lynchaj/NS32016-BC/NS32016-BC-FRONT.jpg

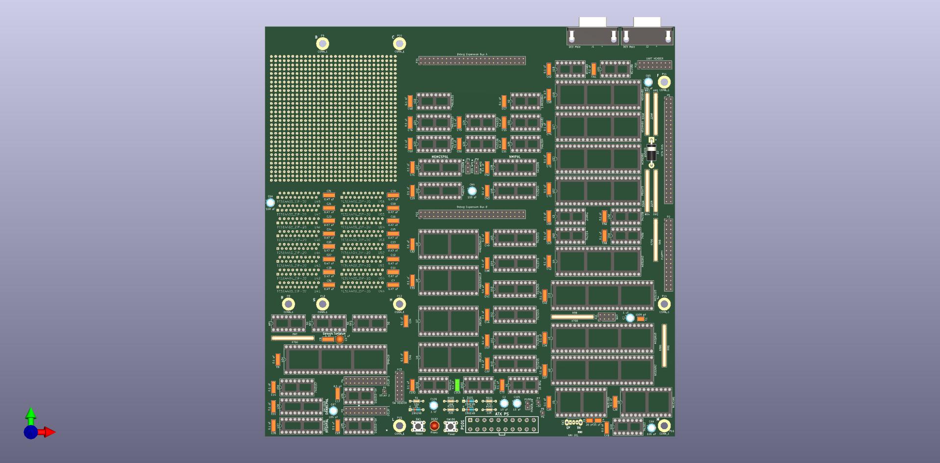
NS32016-BC-FRONT.jpg
