lynchaj/NS32016-BC/NS32016-BC-BACK.jpg

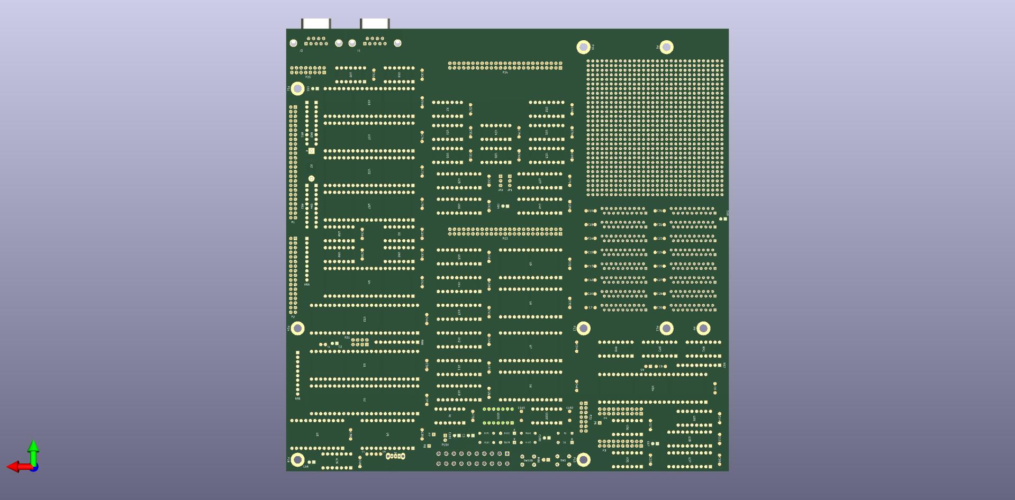
NS32016-BC-BACK.jpg
