lynchaj/NS32016-BC/(list of files, drawings)

Other design files:
NS32016-BC-1.dsn
NS32016-BC.dsn
