lynchaj/NS32016-BC/CPU.kicad_sch

## KiCad design CPU.kicad_sch (2024-06-16)

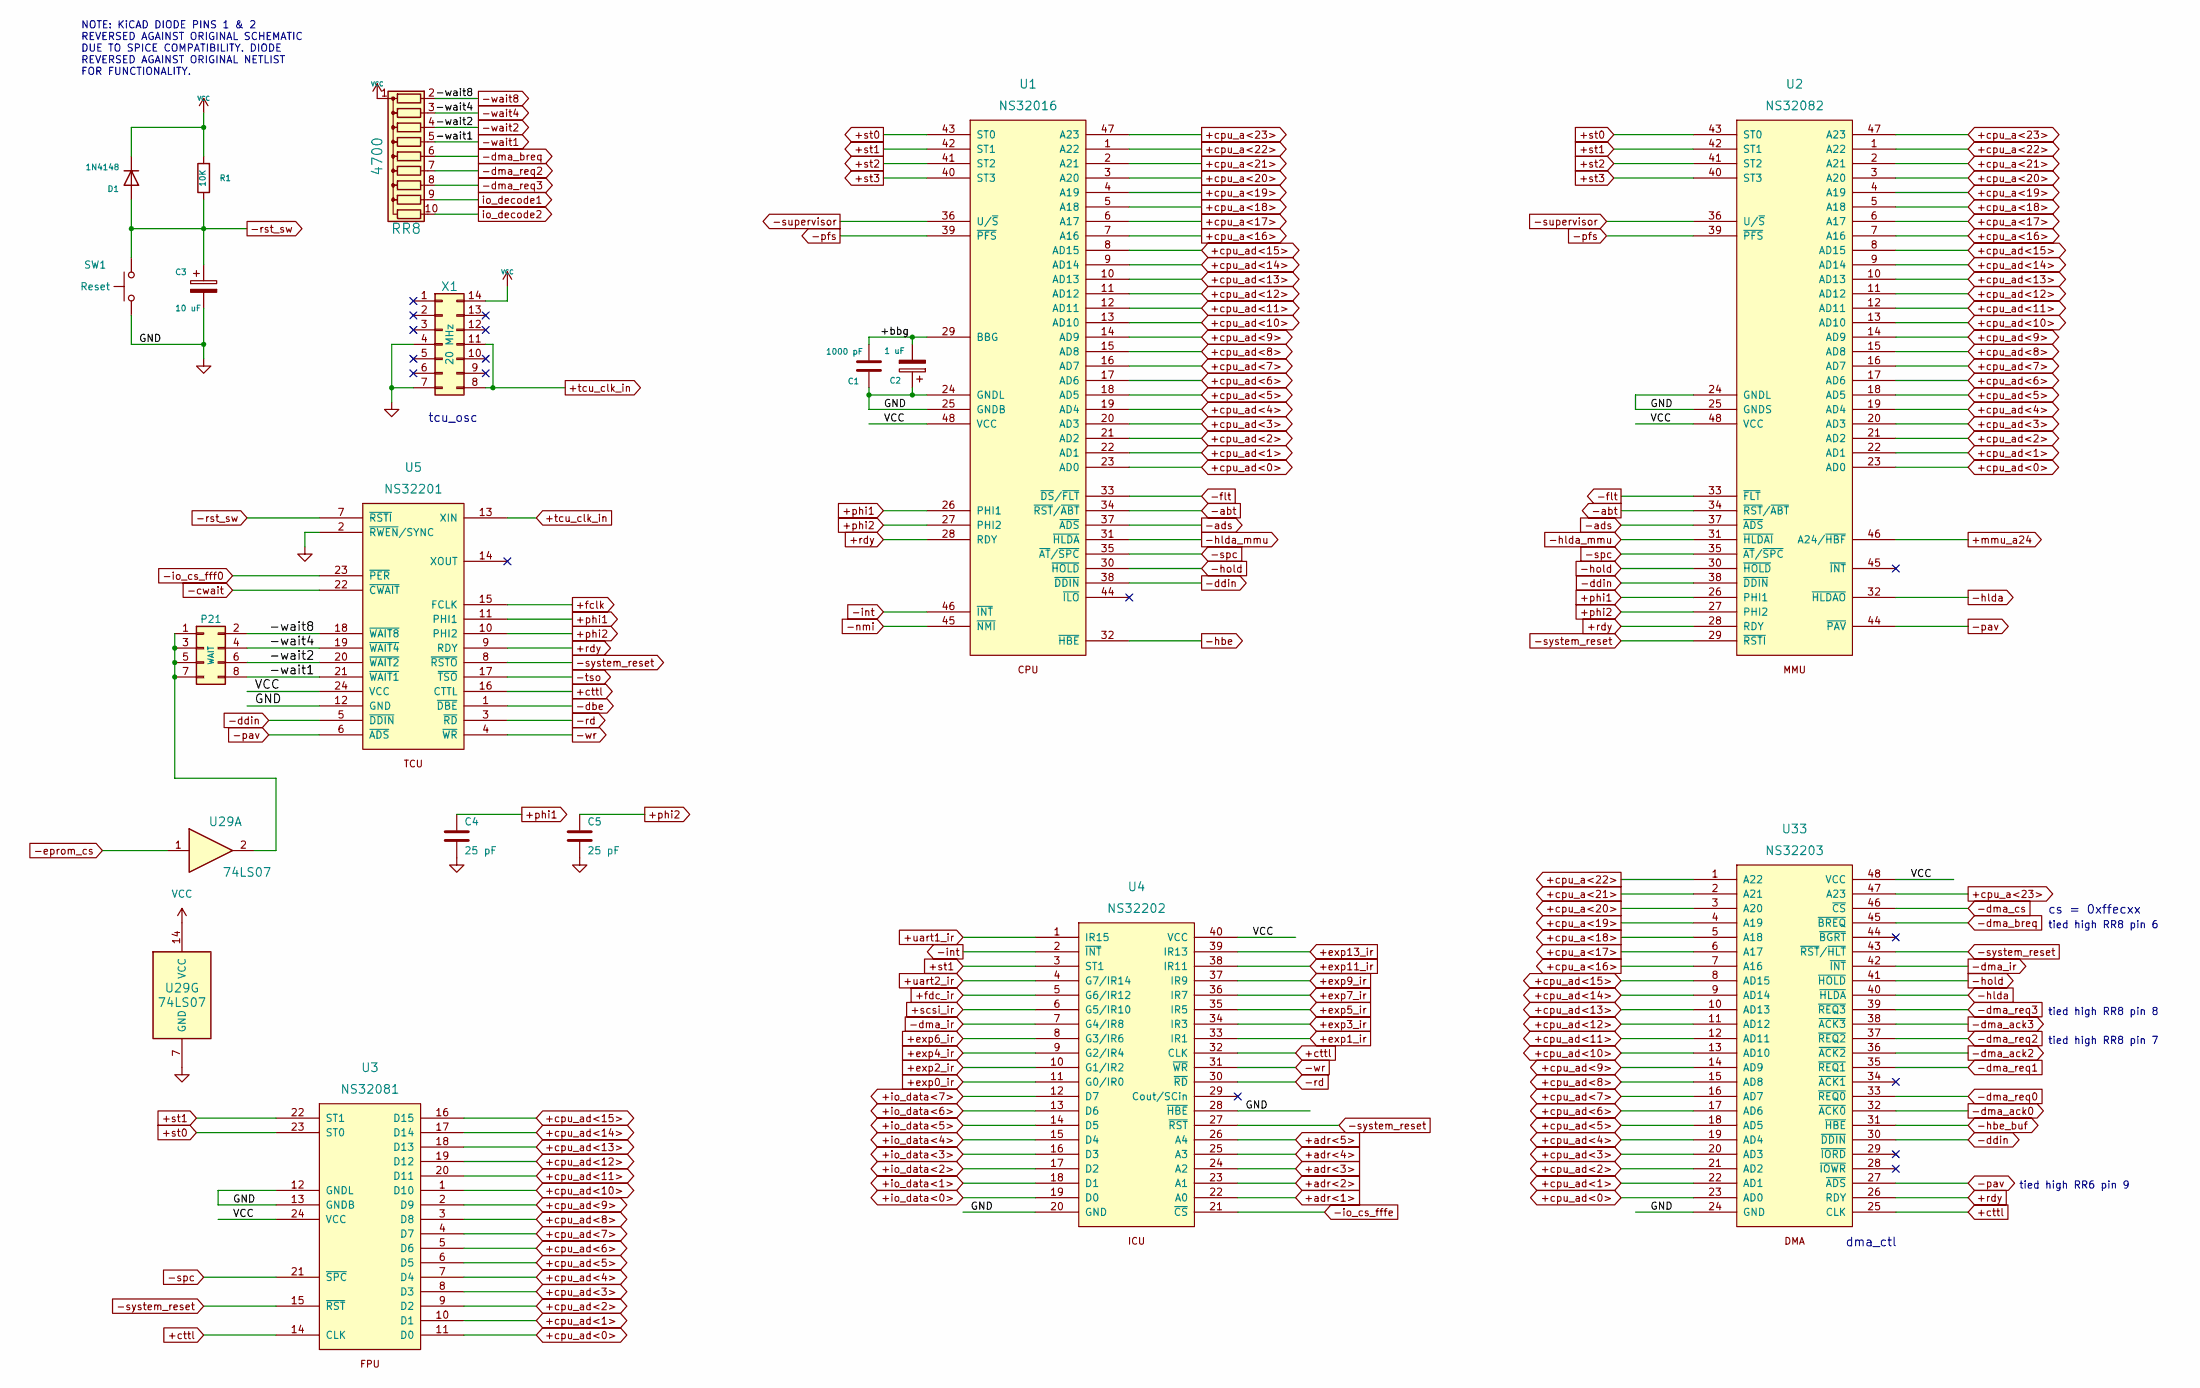
[picture p21: schematic CPU.kicad_sch]

Parts:
C1: 1000 pF; C_Rect_L4.0mm_W2.5mm_P2.50mm
C2: 1 uF; CP_Radial_D5.0mm_P2.50mm
C3: 10 uF; CP_Radial_D5.0mm_P2.50mm
C4, C5: 25 pF; C_Rect_L4.0mm_W2.5mm_P2.50mm
D1: 1N4148; D_DO-35_SOD27_P7.62mm_Horizontal
P21: WAIT; PinHeader_2x04_P2.54mm_Vertical
R1: 10K; R_Axial_DIN0204_L3.6mm_D1.6mm_P7.62mm_Horizontal
RR8: 4700; R_Array_SIP10
SW1: Reset; SW_PUSH_6mm
U1: NS32016; DIP-48_W15.24mm_Socket
U2: NS32082; DIP-48_W15.24mm_Socket
U3: NS32081; DIP-24_W15.24mm_Socket
U4: NS32202; DIP-40_W15.24mm_Socket
U5: NS32201; DIP-24_W15.24mm_Socket
U29: 74LS07; DIP-14_W7.62mm_Socket
U33: NS32203; DIP-48_W15.24mm_Socket
X1: 20 MHz; DIP-14_W7.62mm_Socket

Connections:
+adr<1>: U4.22 (A0)
+adr<2>: U4.23 (A1)
+adr<3>: U4.24 (A2)
+adr<4>: U4.25 (A3)
+adr<5>: U4.26 (A4)
+bbg: C1.1, C2.2, U1.29 (BBG)
+cpu_a<16>: U1.7 (A16), U2.7 (A16), U33.7 (A16)
+cpu_a<17>: U1.6 (A17), U2.6 (A17), U33.6 (A17)
+cpu_a<18>: U1.5 (A18), U2.5 (A18), U33.5 (A18)
+cpu_a<19>: U1.4 (A19), U2.4 (A19), U33.4 (A19)
+cpu_a<20>: U1.3 (A20), U2.3 (A20), U33.3 (A20)
+cpu_a<21>: U1.2 (A21), U2.2 (A21), U33.2 (A21)
+cpu_a<22>: U1.1 (A22), U2.1 (A22), U33.1 (A22)
+cpu_a<23>: U1.47 (A23), U2.47 (A23), U33.47 (A23)
+cpu_ad<0>: U1.23 (AD0), U2.23 (AD0), U3.11 (D0), U33.23 (AD0)
+cpu_ad<1>: U1.22 (AD1), U2.22 (AD1), U3.10 (D1), U33.22 (AD1)
+cpu_ad<2>: U1.21 (AD2), U2.21 (AD2), U3.9 (D2), U33.21 (AD2)
+cpu_ad<3>: U1.20 (AD3), U2.20 (AD3), U3.8 (D3), U33.20 (AD3)
+cpu_ad<4>: U1.19 (AD4), U2.19 (AD4), U3.7 (D4), U33.19 (AD4)
+cpu_ad<5>: U1.18 (AD5), U2.18 (AD5), U3.6 (D5), U33.18 (AD5)
+cpu_ad<6>: U1.17 (AD6), U2.17 (AD6), U3.5 (D6), U33.17 (AD6)
+cpu_ad<7>: U1.16 (AD7), U2.16 (AD7), U3.4 (D7), U33.16 (AD7)
+cpu_ad<8>: U1.15 (AD8), U2.15 (AD8), U3.3 (D8), U33.15 (AD8)
+cpu_ad<9>: U1.14 (AD9), U2.14 (AD9), U3.2 (D9), U33.14 (AD9)
+cpu_ad<10>: U1.13 (AD10), U2.13 (AD10), U3.1 (D10), U33.13 (AD10)
+cpu_ad<11>: U1.12 (AD11), U2.12 (AD11), U3.20 (D11), U33.12 (AD11)
+cpu_ad<12>: U1.11 (AD12), U2.11 (AD12), U3.19 (D12), U33.11 (AD12)
+cpu_ad<13>: U1.10 (AD13), U2.10 (AD13), U3.18 (D13), U33.10 (AD13)
+cpu_ad<14>: U1.9 (AD14), U2.9 (AD14), U3.17 (D14), U33.9 (AD14)
+cpu_ad<15>: U1.8 (AD15), U2.8 (AD15), U3.16 (D15), U33.8 (AD15)
+cttl: U3.14 (CLK), U4.32 (CLK), U5.16 (CTTL), U33.25 (CLK)
+exp0_ir: U4.11 (G0/IR0)
+exp1_ir: U4.33 (IR1)
+exp2_ir: U4.10 (G1/IR2)
+exp3_ir: U4.34 (IR3)
+exp4_ir: U4.9 (G2/IR4)
+exp5_ir: U4.35 (IR5)
+exp6_ir: U4.8 (G3/IR6)
+exp7_ir: U4.36 (IR7)
+exp9_ir: U4.37 (IR9)
+exp11_ir: U4.38 (IR11)
+exp13_ir: U4.39 (IR13)
+fclk: U5.15 (FCLK)
+fdc_ir: U4.5 (G6/IR12)
+io_data<0>: U4.19 (D0)
+io_data<1>: U4.18 (D1)
+io_data<2>: U4.17 (D2)
+io_data<3>: U4.16 (D3)
+io_data<4>: U4.15 (D4)
+io_data<5>: U4.14 (D5)
+io_data<6>: U4.13 (D6)
+io_data<7>: U4.12 (D7)
+mmu_a24: U2.46 (A24/~HBF)
+phi1: C4.1, U1.26 (PHI1), U2.26 (PHI1), U5.11 (PHI1)
+phi2: C5.1, U1.27 (PHI2), U2.27 (PHI2), U5.10 (PHI2)
+rdy: U1.28 (RDY), U2.28 (RDY), U5.9 (RDY), U33.26 (RDY)
+scsi_ir: U4.6 (G5/IR10)
+st0: U1.43 (ST0), U2.43 (ST0), U3.23 (ST0)
+st1: U1.42 (ST1), U2.42 (ST1), U3.22 (ST1), U4.3 (ST1)
+st2: U1.41 (ST2), U2.41 (ST2)
+st3: U1.40 (ST3), U2.40 (ST3)
+tcu_clk_in: U5.13 (XIN), X1.8, X1.11
+uart1_ir: U4.1 (IR15)
+uart2_ir: U4.4 (G7/IR14)
-abt: U1.34 (~RST/~ABT), U2.34 (~RST/~ABT)
-ads: U1.37 (~ADS), U2.37 (~ADS)
-cwait: U5.22 (~CWAIT)
-dbe: U5.1 (~DBE)
-ddin: U1.38 (~DDIN), U2.38 (~DDIN), U5.5 (~DDIN), U33.30 (~DDIN)
-dma_ack0: U33.32 (~ACK0)
-dma_ack2: U33.36 (~ACK2)
-dma_ack3: U33.38 (~ACK3)
-dma_breq: RR8.6 (R5), U33.45 (~BREQ)
-dma_cs: U33.46 (~CS)
-dma_ir: U4.7 (G4/IR8), U33.42 (~INT)
-dma_req0: U33.33 (~REQ0)
-dma_req1: U33.35 (~REQ1)
-dma_req2: RR8.7 (R6), U33.37 (~REQ2)
-dma_req3: RR8.8 (R7), U33.39 (~REQ3)
-eprom_cs: U29.1
-flt: U1.33 (~DS/~FLT), U2.33 (~FLT)
-hbe: U1.32 (~HBE)
-hbe_buf: U33.31 (~HBE)
-hlda: U2.32 (~HLDAO), U33.40 (~HLDA)
-hlda_mmu: U1.31 (~HLDA), U2.31 (~HLDAI)
-hold: U1.30 (~HOLD), U2.30 (~HOLD), U33.41 (~HOLD)
-int: U1.46 (~INT), U4.2 (~INT)
-io_cs_fff0: U5.23 (~PER)
-io_cs_fffe: U4.21 (~CS)
-nmi: U1.45 (~NMI)
-pav: U2.44 (~PAV), U5.6 (~ADS), U33.27 (~ADS)
-pfs: U1.39 (~PFS), U2.39 (~PFS)
-rd: U4.30 (~RD), U5.3 (~RD)
-rst_sw: C3.1, D1.2 (A), R1.1, SW1.2, U5.7 (~RSTI)
-spc: U1.35 (~AT/~SPC), U2.35 (~AT/~SPC), U3.21 (~SPC)
-supervisor: U1.36 (U/~S), U2.36 (U/~S)
-system_reset: U2.29 (~RSTI), U3.15 (~RST), U4.27 (~RST), U5.8 (~RSTO), U33.43 (~RST/~HLT)
-tso: U5.17 (~TSO)
-wait1: P21.8, RR8.5 (R4), U5.21 (~WAIT1)
-wait2: P21.6, RR8.4 (R3), U5.20 (~WAIT2)
-wait4: P21.4, RR8.3 (R2), U5.19 (~WAIT4)
-wait8: P21.2, RR8.2 (R1), U5.18 (~WAIT8)
-wr: U4.31 (~WR), U5.4 (~WR)
GND: C1.2, C2.1, C3.2, C4.2, C5.2, SW1.1, U1.24 (GNDL), U1.25 (GNDB), U2.24 (GNDL), U2.25 (GNDS), U3.12 (GNDL), U3.13 (GNDB), U4.20 (GND), U4.28 (~HBE), U5.2 (~RWEN/SYNC), U5.12 (GND), U29.7 (GND), U33.24 (GND), X1.4, X1.7
unnamed: P21.1, P21.3, P21.5, P21.7, U29.2
VCC: D1.1 (K), R1.2, RR8.1 (common), U1.48 (VCC), U2.48 (VCC), U3.24 (VCC), U4.40 (VCC), U5.24 (VCC), U29.14 (VCC), U33.48 (VCC), X1.14
io_decode1: RR8.9 (R8)
io_decode2: RR8.10 (R9)

Notes on the sheet:
dma_ctl
cs = 0xffecxx
tied high RR8 pin 8
tied high RR6 pin 9
tcu_osc
tied high RR8 pin 6
NOTE: KiCAD DIODE PINS 1 & 2 REVERSED AGAINST ORIGINAL SCHEMATIC DUE TO SPICE COMPATIBILITY. DIODE REVERSED AGAINST ORIGINAL NETLIST FOR FUNCTIONALITY.
tied high RR8 pin 7
