lynchaj/NS32016-BC/DRAM.kicad_sch

## KiCad design DRAM.kicad_sch (2024-06-16)

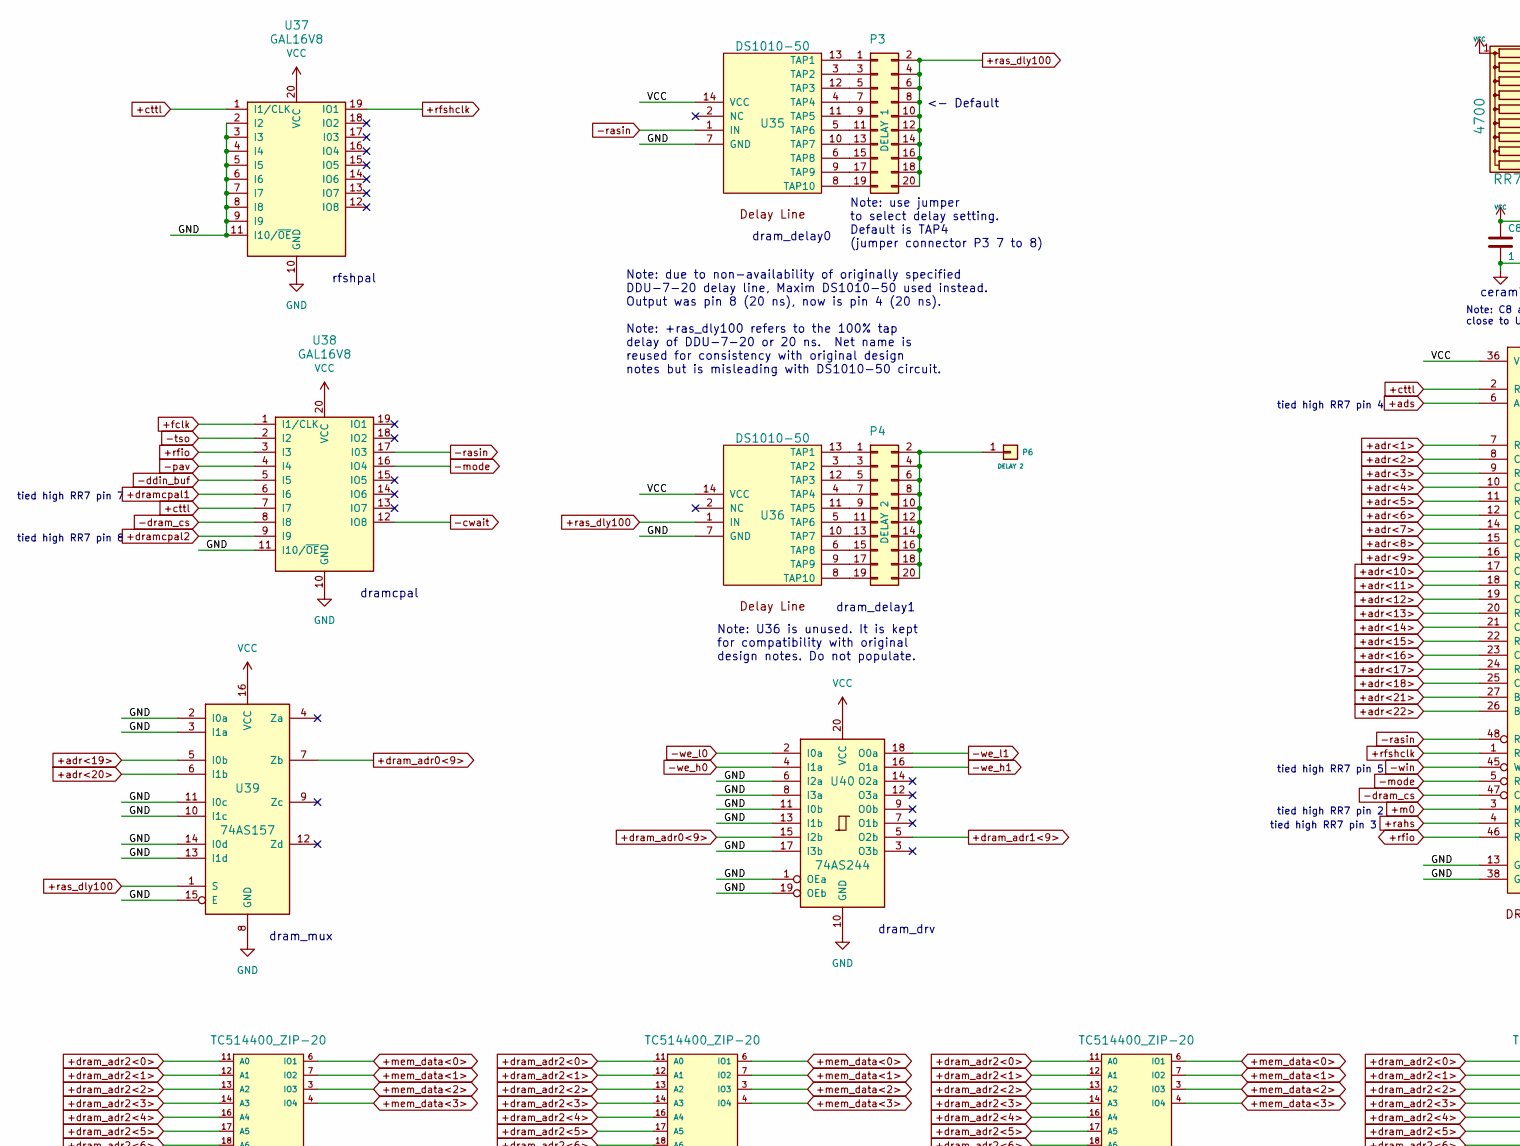
[picture p22: schematic DRAM.kicad_sch, part in row 1, column 1]

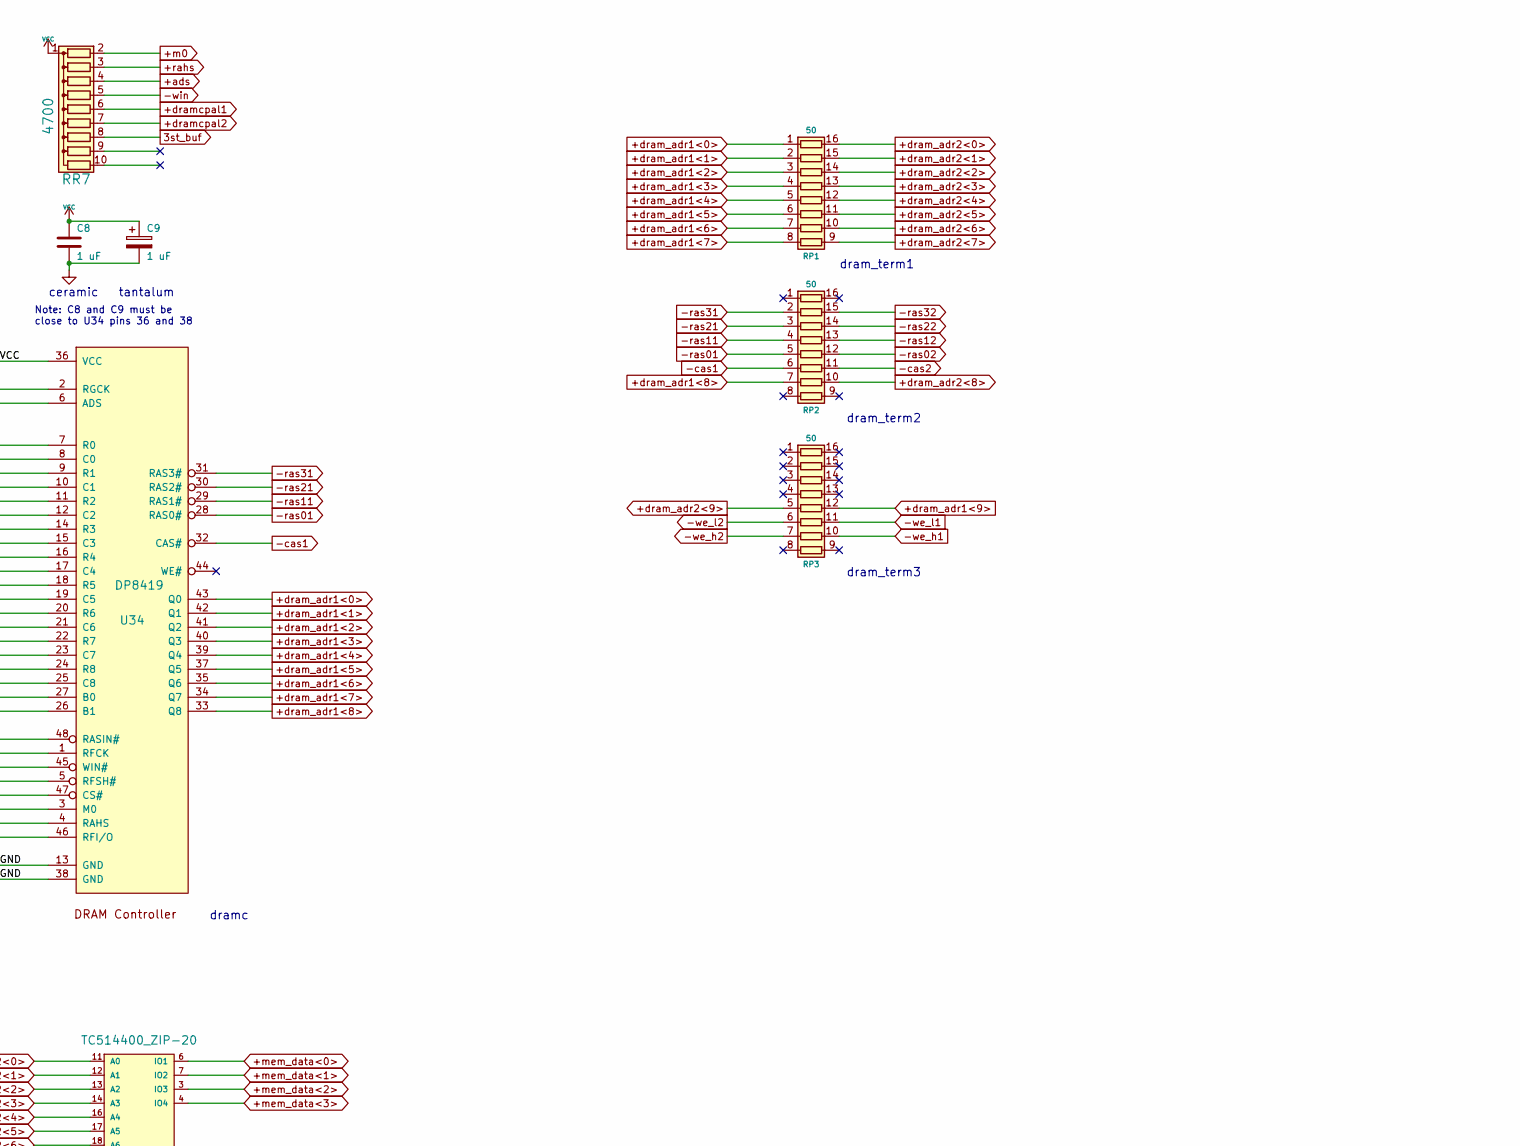
[picture p23: schematic DRAM.kicad_sch, part in row 1, column 2]

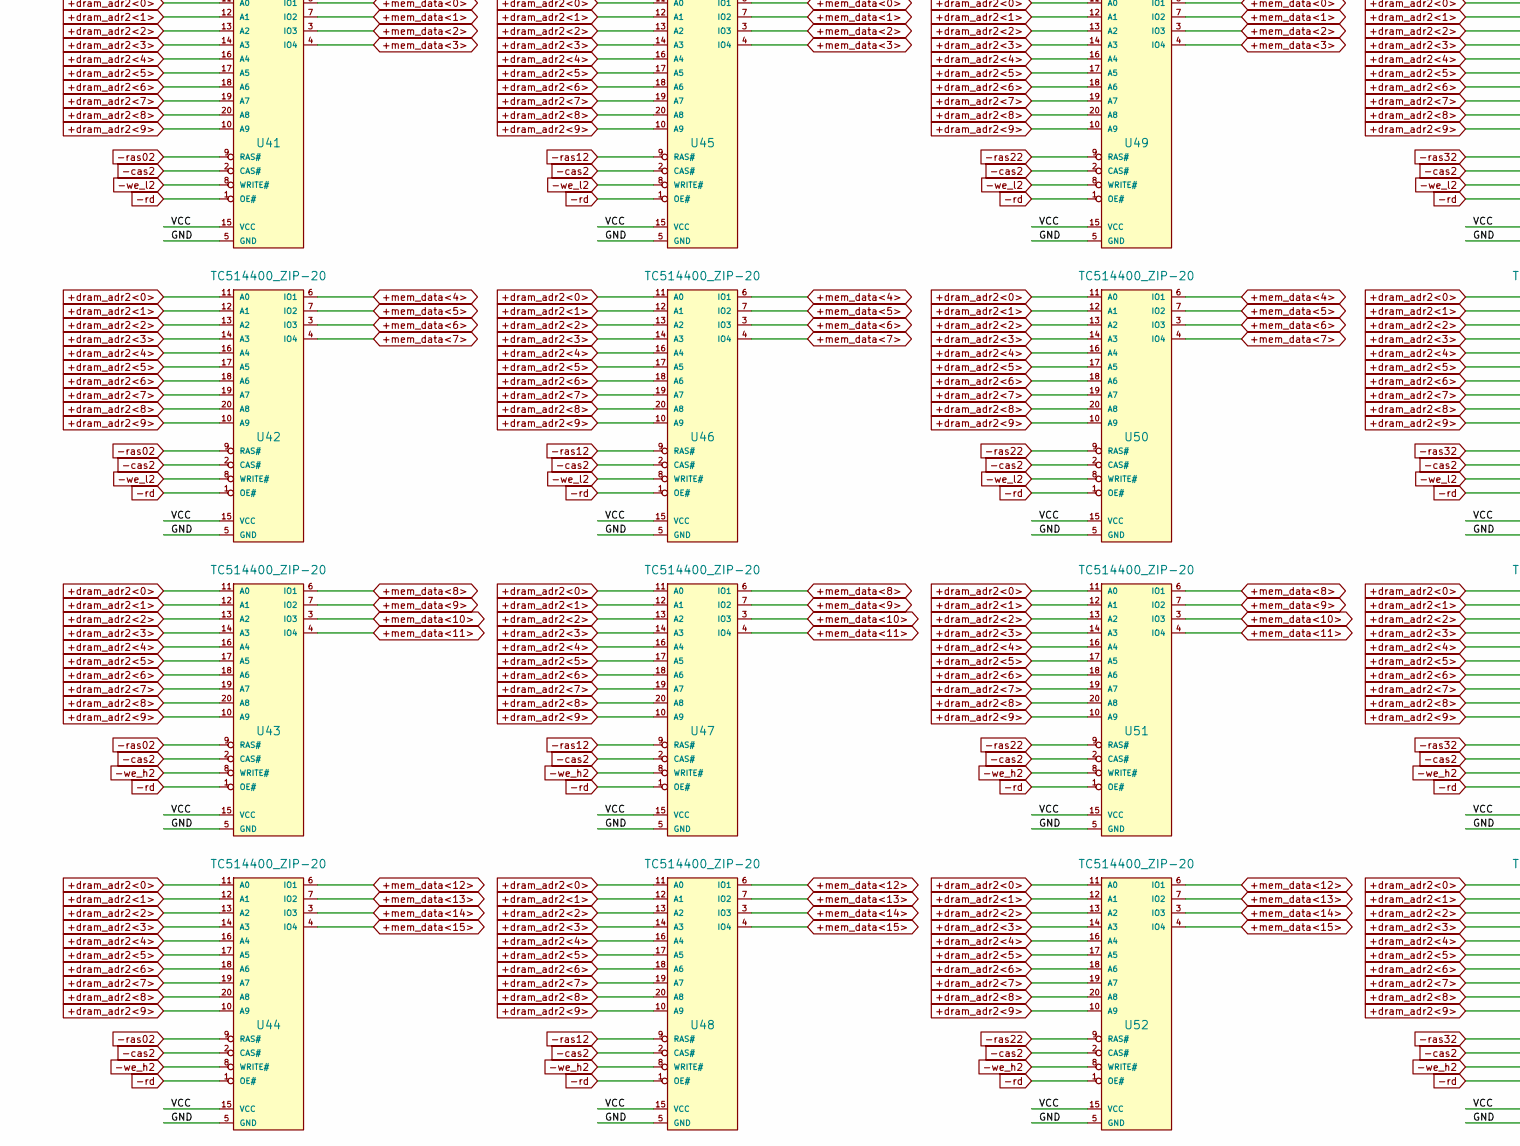
[picture p24: schematic DRAM.kicad_sch, part in row 2, column 1]

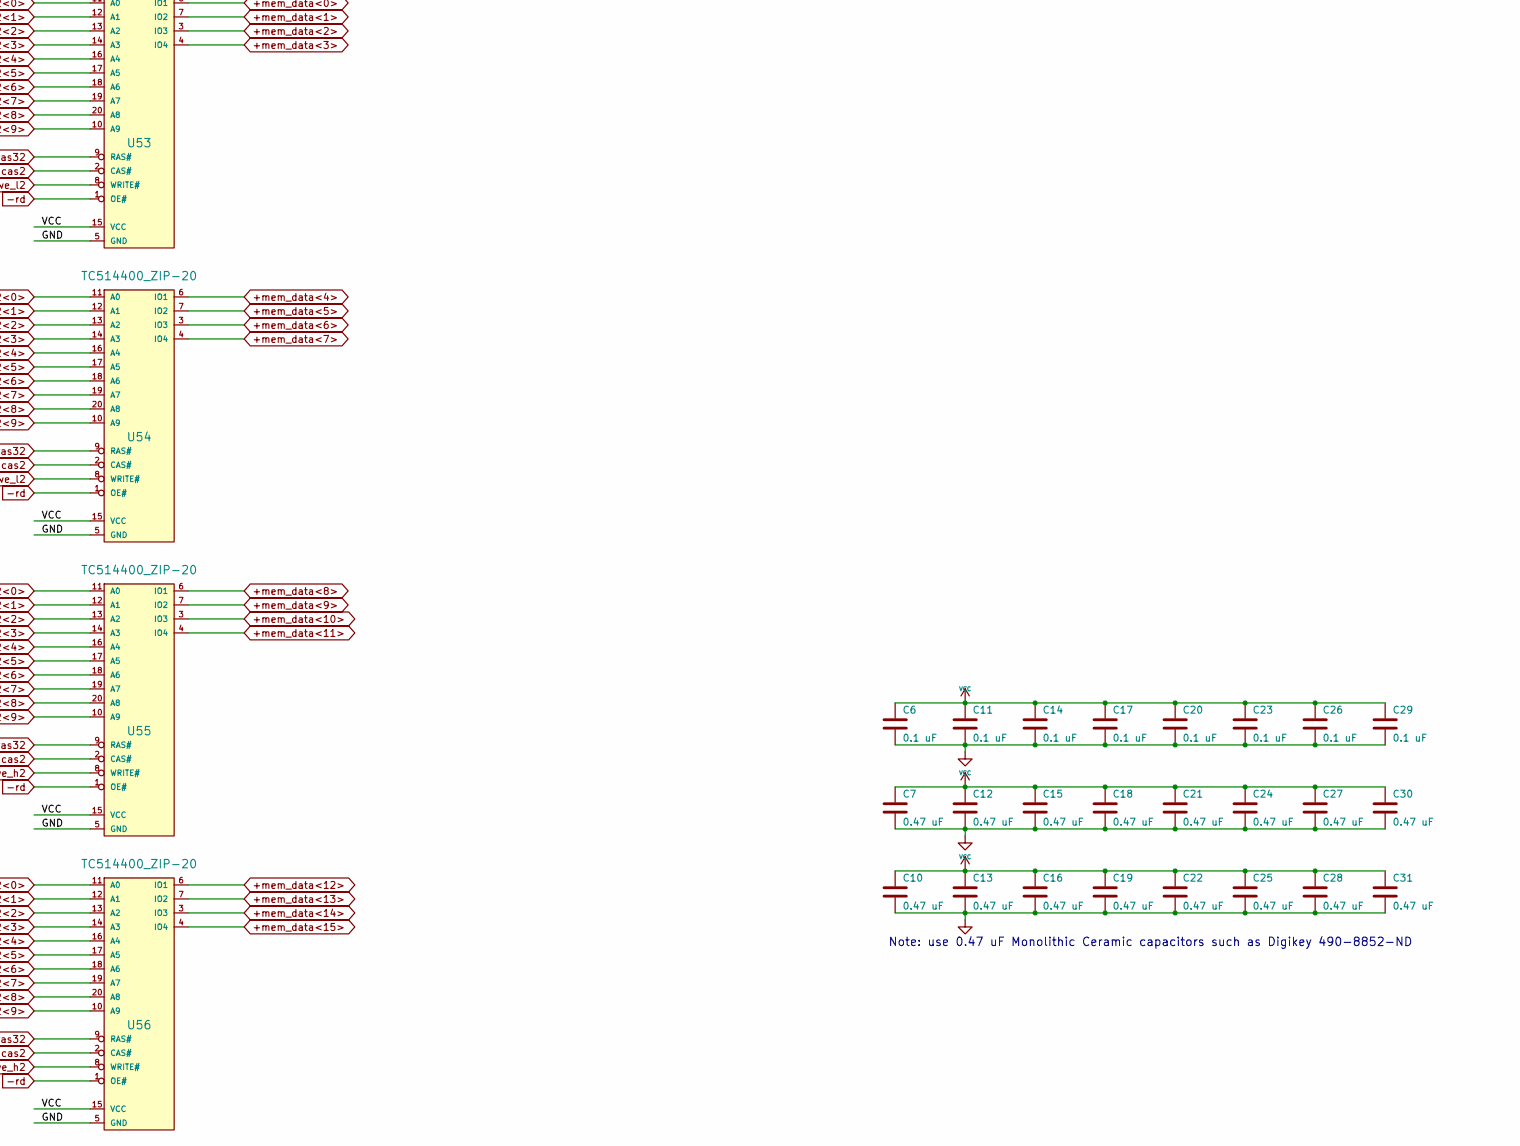
[picture p25: schematic DRAM.kicad_sch, part in row 2, column 2]

Parts:
C6, C11, C14, C17, C20, C23, C26, C29: 0.1 uF; C_Rect_L7.0mm_W2.5mm_P5.00mm
C7, C10, C12, C13, C15, C16, C18, C19, C21, C22, C24, C25, C27, C28, C30, C31: 0.47 uF; C_Rect_L7.0mm_W2.5mm_P5.00mm
C8: 1 uF; C_Rect_L7.0mm_W2.5mm_P5.00mm
C9: 1 uF; CP_Radial_Tantal_D5.0mm_P2.50mm
P3: DELAY 1; PinHeader_2x10_P2.54mm_Vertical
P4: DELAY 2; PinHeader_2x10_P2.54mm_Vertical
P6: DELAY 2; PinHeader_1x01_P2.54mm_Vertical
RP1, RP2, RP3: 50; DIP-16_W7.62mm_Socket
RR7: 4700; R_Array_SIP10
U34: DP8419; DIP-48_W15.24mm_Socket
U35, U36: DS1010-50; DIP-14_W7.62mm_Socket
U37, U38: GAL16V8; DIP-20_W7.62mm_Socket
U39: 74AS157; DIP-16_W7.62mm_Socket
U40: 74AS244; DIP-20_W7.62mm_Socket
U41, U42, U43, U44, U45, U46, U47, U48, U49, U50, U51, U52, U53, U54, U55, U56: TC514400_ZIP-20; TC14400_ZIP-20

Connections:
3st_buf: RR7.8 (R7)
+adr<1>: U34.7 (R0)
+adr<2>: U34.8 (C0)
+adr<3>: U34.9 (R1)
+adr<4>: U34.10 (C1)
+adr<5>: U34.11 (R2)
+adr<6>: U34.12 (C2)
+adr<7>: U34.14 (R3)
+adr<8>: U34.15 (C3)
+adr<9>: U34.16 (R4)
+adr<10>: U34.17 (C4)
+adr<11>: U34.18 (R5)
+adr<12>: U34.19 (C5)
+adr<13>: U34.20 (R6)
+adr<14>: U34.21 (C6)
+adr<15>: U34.22 (R7)
+adr<16>: U34.23 (C7)
+adr<17>: U34.24 (R8)
+adr<18>: U34.25 (C8)
+adr<19>: U39.5 (I0b)
+adr<20>: U39.6 (I1b)
+adr<21>: U34.27 (B0)
+adr<22>: U34.26 (B1)
+ads: RR7.4 (R3), U34.6 (ADS)
+cttl: U34.2 (RGCK), U37.1 (I1/CLK), U38.7 (I7)
+dram_adr0<9>: U39.7 (Zb), U40.15 (I2b)
+dram_adr1<0>: RP1.1 (R1.1), U34.43 (Q0)
+dram_adr1<1>: RP1.2 (R2.1), U34.42 (Q1)
+dram_adr1<2>: RP1.3 (R3.1), U34.41 (Q2)
+dram_adr1<3>: RP1.4 (R4.1), U34.40 (Q3)
+dram_adr1<4>: RP1.5 (R5.1), U34.39 (Q4)
+dram_adr1<5>: RP1.6 (R6.1), U34.37 (Q5)
+dram_adr1<6>: RP1.7 (R7.1), U34.35 (Q6)
+dram_adr1<7>: RP1.8 (R8.1), U34.34 (Q7)
+dram_adr1<8>: RP2.7 (R7.1), U34.33 (Q8)
+dram_adr1<9>: RP3.12 (R5.2), U40.5 (O2b)
+dram_adr2<0>: RP1.16 (R1.2), U41.11 (A0), U42.11 (A0), U43.11 (A0), U44.11 (A0), U45.11 (A0), U46.11 (A0), U47.11 (A0), U48.11 (A0), U49.11 (A0), U50.11 (A0), U51.11 (A0), U52.11 (A0), U53.11 (A0), U54.11 (A0), U55.11 (A0), U56.11 (A0)
+dram_adr2<1>: RP1.15 (R2.2), U41.12 (A1), U42.12 (A1), U43.12 (A1), U44.12 (A1), U45.12 (A1), U46.12 (A1), U47.12 (A1), U48.12 (A1), U49.12 (A1), U50.12 (A1), U51.12 (A1), U52.12 (A1), U53.12 (A1), U54.12 (A1), U55.12 (A1), U56.12 (A1)
+dram_adr2<2>: RP1.14 (R3.2), U41.13 (A2), U42.13 (A2), U43.13 (A2), U44.13 (A2), U45.13 (A2), U46.13 (A2), U47.13 (A2), U48.13 (A2), U49.13 (A2), U50.13 (A2), U51.13 (A2), U52.13 (A2), U53.13 (A2), U54.13 (A2), U55.13 (A2), U56.13 (A2)
+dram_adr2<3>: RP1.13 (R4.2), U41.14 (A3), U42.14 (A3), U43.14 (A3), U44.14 (A3), U45.14 (A3), U46.14 (A3), U47.14 (A3), U48.14 (A3), U49.14 (A3), U50.14 (A3), U51.14 (A3), U52.14 (A3), U53.14 (A3), U54.14 (A3), U55.14 (A3), U56.14 (A3)
+dram_adr2<4>: RP1.12 (R5.2), U41.16 (A4), U42.16 (A4), U43.16 (A4), U44.16 (A4), U45.16 (A4), U46.16 (A4), U47.16 (A4), U48.16 (A4), U49.16 (A4), U50.16 (A4), U51.16 (A4), U52.16 (A4), U53.16 (A4), U54.16 (A4), U55.16 (A4), U56.16 (A4)
+dram_adr2<5>: RP1.11 (R6.2), U41.17 (A5), U42.17 (A5), U43.17 (A5), U44.17 (A5), U45.17 (A5), U46.17 (A5), U47.17 (A5), U48.17 (A5), U49.17 (A5), U50.17 (A5), U51.17 (A5), U52.17 (A5), U53.17 (A5), U54.17 (A5), U55.17 (A5), U56.17 (A5)
+dram_adr2<6>: RP1.10 (R7.2), U41.18 (A6), U42.18 (A6), U43.18 (A6), U44.18 (A6), U45.18 (A6), U46.18 (A6), U47.18 (A6), U48.18 (A6), U49.18 (A6), U50.18 (A6), U51.18 (A6), U52.18 (A6), U53.18 (A6), U54.18 (A6), U55.18 (A6), U56.18 (A6)
+dram_adr2<7>: RP1.9 (R8.2), U41.19 (A7), U42.19 (A7), U43.19 (A7), U44.19 (A7), U45.19 (A7), U46.19 (A7), U47.19 (A7), U48.19 (A7), U49.19 (A7), U50.19 (A7), U51.19 (A7), U52.19 (A7), U53.19 (A7), U54.19 (A7), U55.19 (A7), U56.19 (A7)
+dram_adr2<8>: RP2.10 (R7.2), U41.20 (A8), U42.20 (A8), U43.20 (A8), U44.20 (A8), U45.20 (A8), U46.20 (A8), U47.20 (A8), U48.20 (A8), U49.20 (A8), U50.20 (A8), U51.20 (A8), U52.20 (A8), U53.20 (A8), U54.20 (A8), U55.20 (A8), U56.20 (A8)
+dram_adr2<9>: RP3.5 (R5.1), U41.10 (A9), U42.10 (A9), U43.10 (A9), U44.10 (A9), U45.10 (A9), U46.10 (A9), U47.10 (A9), U48.10 (A9), U49.10 (A9), U50.10 (A9), U51.10 (A9), U52.10 (A9), U53.10 (A9), U54.10 (A9), U55.10 (A9), U56.10 (A9)
+dramcpal1: RR7.6 (R5), U38.6 (I6)
+dramcpal2: RR7.7 (R6), U38.9 (I9)
+fclk: U38.1 (I1/CLK)
+m0: RR7.2 (R1), U34.3 (M0)
+mem_data<0>: U41.6 (IO1), U45.6 (IO1), U49.6 (IO1), U53.6 (IO1)
+mem_data<1>: U41.7 (IO2), U45.7 (IO2), U49.7 (IO2), U53.7 (IO2)
+mem_data<2>: U41.3 (IO3), U45.3 (IO3), U49.3 (IO3), U53.3 (IO3)
+mem_data<3>: U41.4 (IO4), U45.4 (IO4), U49.4 (IO4), U53.4 (IO4)
+mem_data<4>: U42.6 (IO1), U46.6 (IO1), U50.6 (IO1), U54.6 (IO1)
+mem_data<5>: U42.7 (IO2), U46.7 (IO2), U50.7 (IO2), U54.7 (IO2)
+mem_data<6>: U42.3 (IO3), U46.3 (IO3), U50.3 (IO3), U54.3 (IO3)
+mem_data<7>: U42.4 (IO4), U46.4 (IO4), U50.4 (IO4), U54.4 (IO4)
+mem_data<8>: U43.6 (IO1), U47.6 (IO1), U51.6 (IO1), U55.6 (IO1)
+mem_data<9>: U43.7 (IO2), U47.7 (IO2), U51.7 (IO2), U55.7 (IO2)
+mem_data<10>: U43.3 (IO3), U47.3 (IO3), U51.3 (IO3), U55.3 (IO3)
+mem_data<11>: U43.4 (IO4), U47.4 (IO4), U51.4 (IO4), U55.4 (IO4)
+mem_data<12>: U44.6 (IO1), U48.6 (IO1), U52.6 (IO1), U56.6 (IO1)
+mem_data<13>: U44.7 (IO2), U48.7 (IO2), U52.7 (IO2), U56.7 (IO2)
+mem_data<14>: U44.3 (IO3), U48.3 (IO3), U52.3 (IO3), U56.3 (IO3)
+mem_data<15>: U44.4 (IO4), U48.4 (IO4), U52.4 (IO4), U56.4 (IO4)
+rahs: RR7.3 (R2), U34.4 (RAHS)
+ras_dly100: P3.2, P3.4, P3.6, P3.8, P3.10, P3.12, P3.14, P3.16, P3.18, P3.20, U36.1 (IN), U39.1 (S)
+rfio: U34.46 (RFI/O), U38.3 (I3)
+rfshclk: U34.1 (RFCK), U37.19 (IO1)
-cas1: RP2.6 (R6.1), U34.32 (CAS#)
-cas2: RP2.11 (R6.2), U41.2 (CAS#), U42.2 (CAS#), U43.2 (CAS#), U44.2 (CAS#), U45.2 (CAS#), U46.2 (CAS#), U47.2 (CAS#), U48.2 (CAS#), U49.2 (CAS#), U50.2 (CAS#), U51.2 (CAS#), U52.2 (CAS#), U53.2 (CAS#), U54.2 (CAS#), U55.2 (CAS#), U56.2 (CAS#)
-cwait: U38.12 (IO8)
-ddin_buf: U38.5 (I5)
-dram_cs: U34.47 (CS#), U38.8 (I8)
-mode: U34.5 (RFSH#), U38.16 (IO4)
-pav: U38.4 (I4)
-ras01: RP2.5 (R5.1), U34.28 (RAS0#)
-ras02: RP2.12 (R5.2), U41.9 (RAS#), U42.9 (RAS#), U43.9 (RAS#), U44.9 (RAS#)
-ras11: RP2.4 (R4.1), U34.29 (RAS1#)
-ras12: RP2.13 (R4.2), U45.9 (RAS#), U46.9 (RAS#), U47.9 (RAS#), U48.9 (RAS#)
-ras21: RP2.3 (R3.1), U34.30 (RAS2#)
-ras22: RP2.14 (R3.2), U49.9 (RAS#), U50.9 (RAS#), U51.9 (RAS#), U52.9 (RAS#)
-ras31: RP2.2 (R2.1), U34.31 (RAS3#)
-ras32: RP2.15 (R2.2), U53.9 (RAS#), U54.9 (RAS#), U55.9 (RAS#), U56.9 (RAS#)
-rasin: U34.48 (RASIN#), U35.1 (IN), U38.17 (I03)
-rd: U41.1 (OE#), U42.1 (OE#), U43.1 (OE#), U44.1 (OE#), U45.1 (OE#), U46.1 (OE#), U47.1 (OE#), U48.1 (OE#), U49.1 (OE#), U50.1 (OE#), U51.1 (OE#), U52.1 (OE#), U53.1 (OE#), U54.1 (OE#), U55.1 (OE#), U56.1 (OE#)
-tso: U38.2 (I2)
-we_h0: U40.4 (I1a)
-we_h1: RP3.10 (R7.2), U40.16 (O1a)
-we_h2: RP3.7 (R7.1), U43.8 (WRITE#), U44.8 (WRITE#), U47.8 (WRITE#), U48.8 (WRITE#), U51.8 (WRITE#), U52.8 (WRITE#), U55.8 (WRITE#), U56.8 (WRITE#)
-we_l0: U40.2 (I0a)
-we_l1: RP3.11 (R6.2), U40.18 (O0a)
-we_l2: RP3.6 (R6.1), U41.8 (WRITE#), U42.8 (WRITE#), U45.8 (WRITE#), U46.8 (WRITE#), U49.8 (WRITE#), U50.8 (WRITE#), U53.8 (WRITE#), U54.8 (WRITE#)
-win: RR7.5 (R4), U34.45 (WIN#)
GND: C6.2, C7.2, C8.2, C9.2, C10.2, C11.2, C12.2, C13.2, C14.2, C15.2, C16.2, C17.2, C18.2, C19.2, C20.2, C21.2, C22.2, C23.2, C24.2, C25.2, C26.2, C27.2, C28.2, C29.2, C30.2, C31.2, U34.13 (GND), U34.38 (GND), U35.7 (GND), U36.7 (GND), U37.2 (I2), U37.3 (I3), U37.4 (I4), U37.5 (I5), U37.6 (I6), U37.7 (I7), U37.8 (I8), U37.9 (I9), U37.10 (GND), U37.11 (I10/~OE), U38.10 (GND), U38.11 (I10/~OE), U39.2 (I0a), U39.3 (I1a), U39.8 (GND), U39.10 (I1c), U39.11 (I0c), U39.13 (I1d), U39.14 (I0d), U39.15 (E), U40.1 (OEa), U40.6 (I2a), U40.8 (I3a), U40.10 (GND), U40.11 (I0b), U40.13 (I1b), U40.17 (I3b), U40.19 (OEb), U41.5 (GND), U42.5 (GND), U43.5 (GND), U44.5 (GND), U45.5 (GND), U46.5 (GND), U47.5 (GND), U48.5 (GND), U49.5 (GND), U50.5 (GND), U51.5 (GND), U52.5 (GND), U53.5 (GND), U54.5 (GND), U55.5 (GND), U56.5 (GND)
unnamed: P3.1, U35.13 (TAP1)
unnamed: P3.3, U35.3 (TAP2)
unnamed: P3.5, U35.12 (TAP3)
unnamed: P3.7, U35.4 (TAP4)
unnamed: P3.9, U35.11 (TAP5)
unnamed: P3.11, U35.5 (TAP6)
unnamed: P3.13, U35.10 (TAP7)
unnamed: P3.15, U35.6 (TAP8)
unnamed: P3.17, U35.9 (TAP9)
unnamed: P3.19, U35.8 (TAP10)
unnamed: P4.1, U36.13 (TAP1)
unnamed: P4.3, U36.3 (TAP2)
unnamed: P4.5, U36.12 (TAP3)
unnamed: P4.7, U36.4 (TAP4)
unnamed: P4.9, U36.11 (TAP5)
unnamed: P4.2, P4.4, P4.6, P4.8, P4.10, P4.12, P4.14, P4.16, P4.18, P4.20, P6.1
unnamed: P4.11, U36.5 (TAP6)
unnamed: P4.13, U36.10 (TAP7)
unnamed: P4.15, U36.6 (TAP8)
unnamed: P4.17, U36.9 (TAP9)
unnamed: P4.19, U36.8 (TAP10)
VCC: C6.1, C7.1, C8.1, C9.1, C10.1, C11.1, C12.1, C13.1, C14.1, C15.1, C16.1, C17.1, C18.1, C19.1, C20.1, C21.1, C22.1, C23.1, C24.1, C25.1, C26.1, C27.1, C28.1, C29.1, C30.1, C31.1, RR7.1 (common), U34.36 (VCC), U35.14 (VCC), U36.14 (VCC), U37.20 (VCC), U38.20 (VCC), U39.16 (VCC), U40.20 (VCC), U41.15 (VCC), U42.15 (VCC), U43.15 (VCC), U44.15 (VCC), U45.15 (VCC), U46.15 (VCC), U47.15 (VCC), U48.15 (VCC), U49.15 (VCC), U50.15 (VCC), U51.15 (VCC), U52.15 (VCC), U53.15 (VCC), U54.15 (VCC), U55.15 (VCC), U56.15 (VCC)

Notes on the sheet:
Note: due to non-availability of originally specified DDU-7-20 delay line, Maxim DS1010-50 used instead. Output was pin 8 (20 ns), now is pin 4 (20 ns). Note: +ras_dly100 refers to the 100% tap delay of DDU-7-20 or 20 ns. Net name is reused for consistency with original design notes but is misleadi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
dram_mux
dram_term1
tantalum
tied high RR7 pin 5
dram_term2
tied high RR7 pin 3
Note: C8 and C9 must be close to U34 pins 36 and 38
dram_delay1
tied high RR7 pin 4
<- Default
tied high RR7 pin 8
ceramic
dramc
Note: use jumper to select delay setting. Default is TAP4 (jumper connector P3 7 to 8)
dramcpal
dram_term3
tied high RR7 pin 2
tied high RR7 pin 7
rfshpal
Note: U36 is unused. It is kept for compatibility with original design notes. Do not populate.
dram_delay0
Note: use 0.47 uF Monolithic Ceramic capacitors such as Digikey 490-8852-ND
dram_drv
