lynchaj/NS32016-BC/Decoders.kicad_sch

## KiCad design Decoders.kicad_sch (2024-06-16)

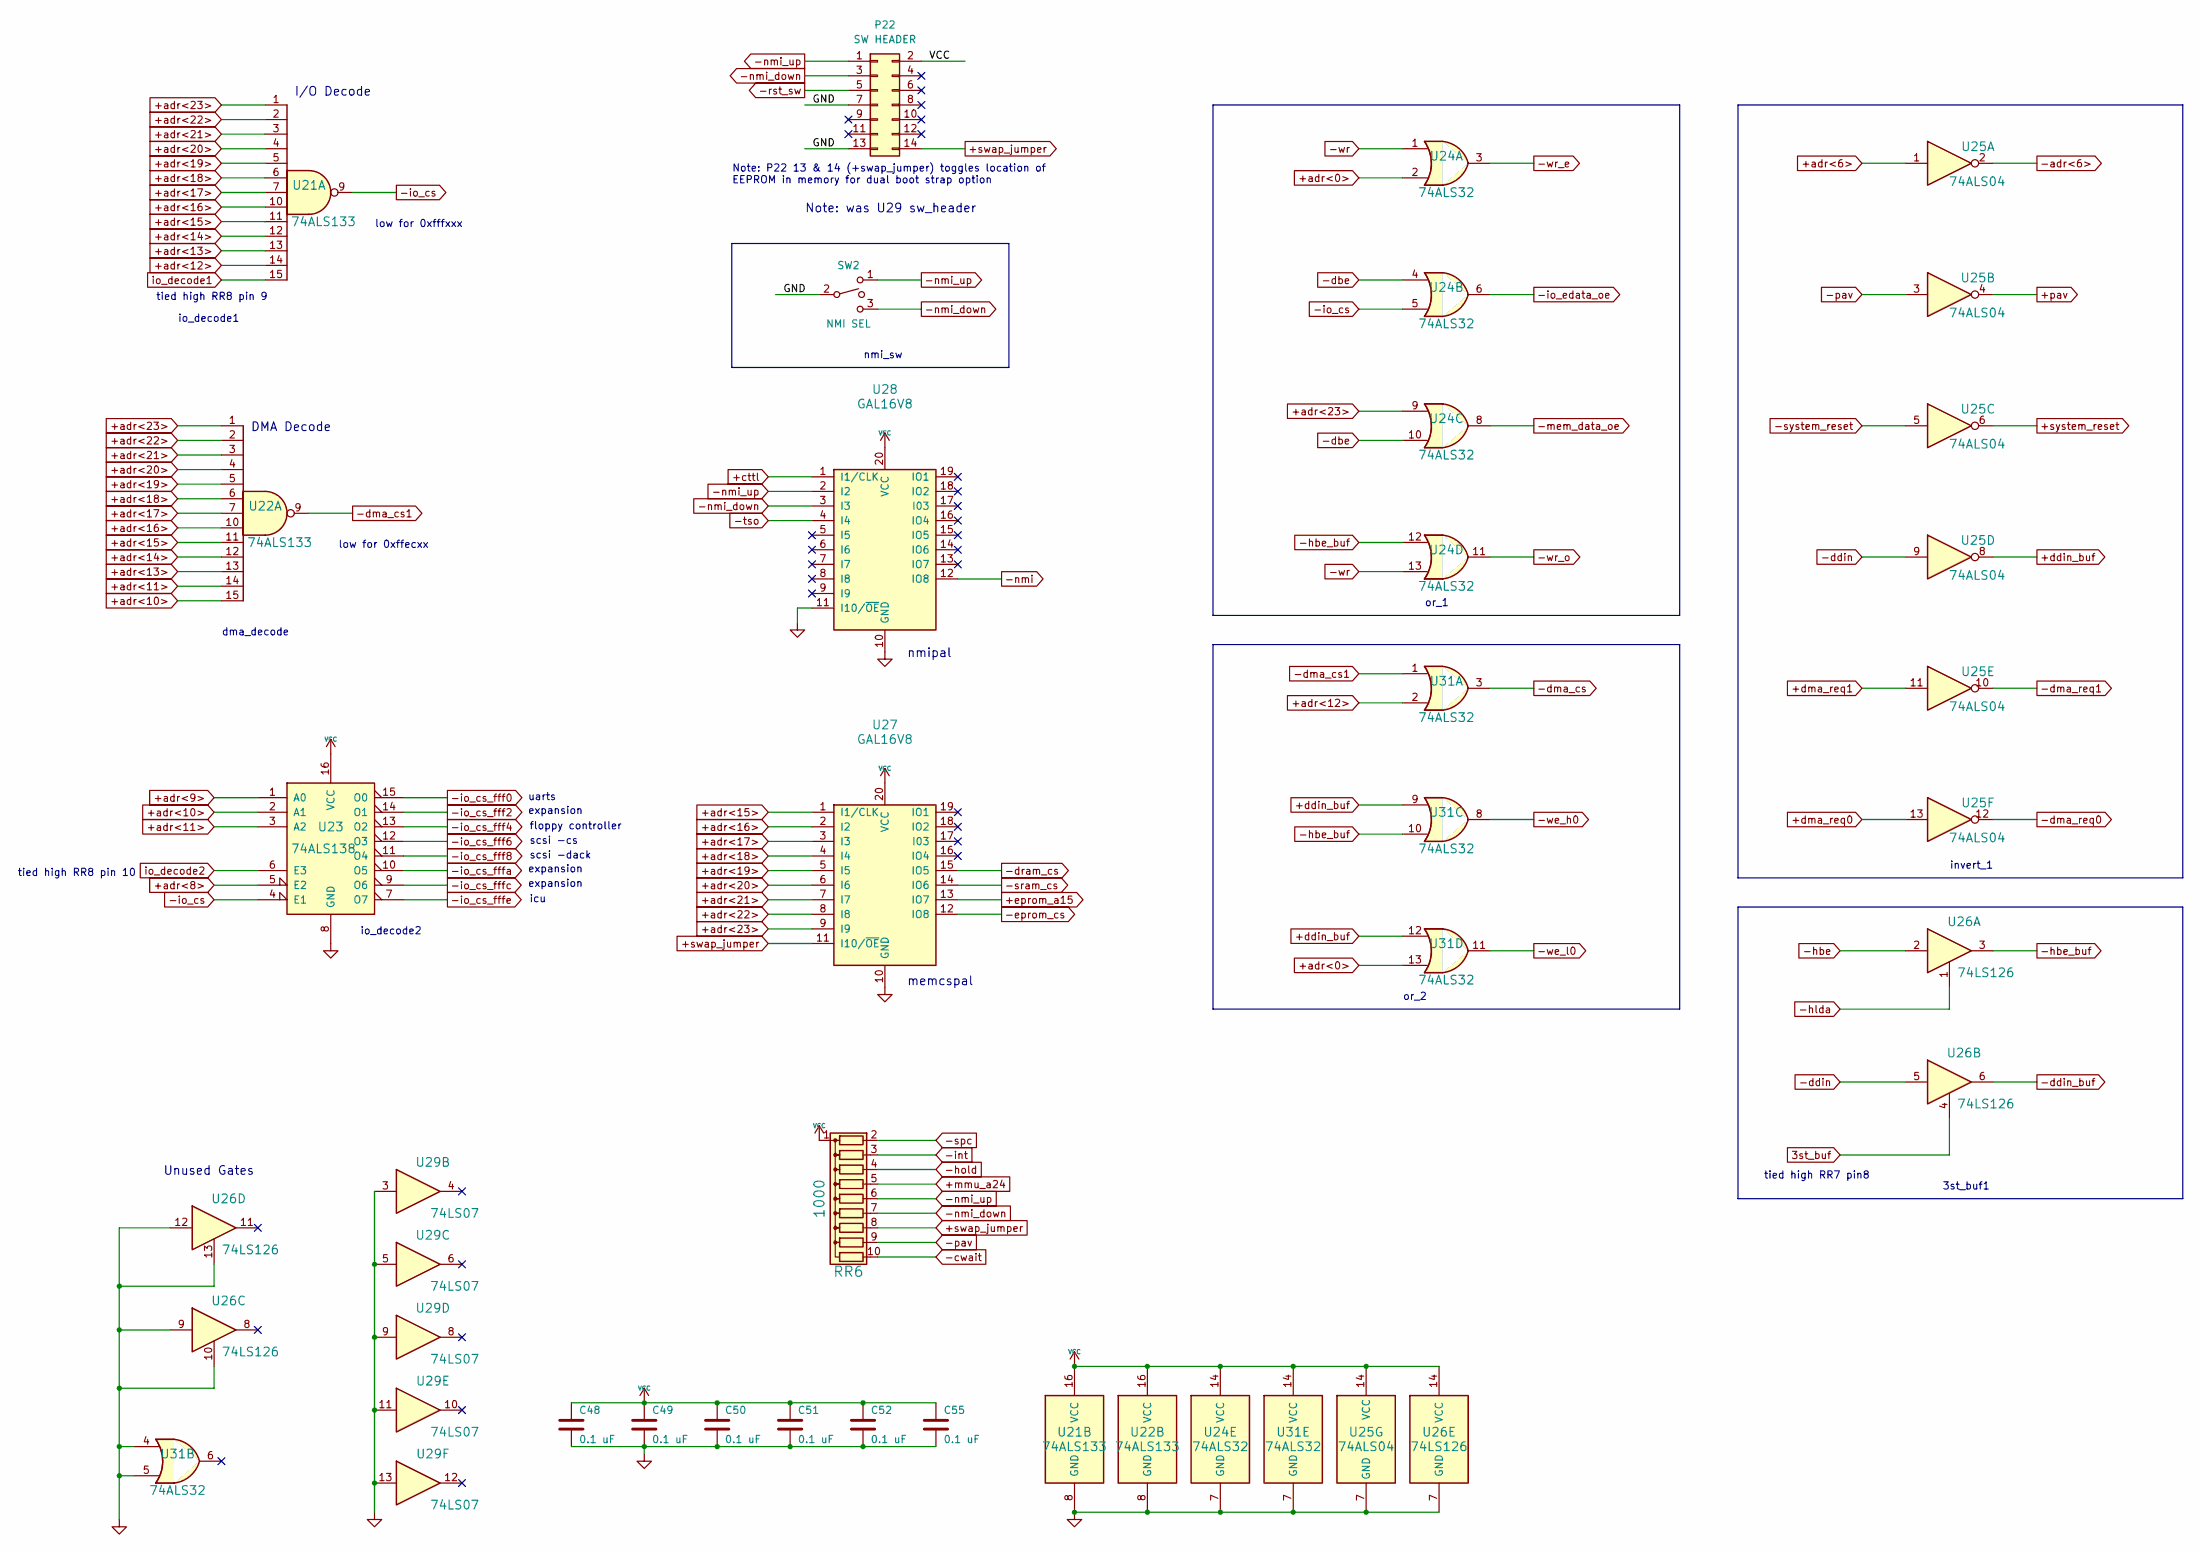
[picture p26: schematic Decoders.kicad_sch]

Parts:
C48, C49, C50, C51, C52, C55: 0.1 uF; C_Rect_L7.0mm_W2.5mm_P5.00mm
P22: SW HEADER; PinHeader_2x07_P2.54mm_Vertical
RR6: 1000; R_Array_SIP10
SW2: NMI SEL; SW_CuK_OS102011MA1QN1_SPDT_Angled
U21, U22: 74ALS133; DIP-16_W7.62mm_Socket
U23: 74ALS138; DIP-16_W7.62mm_Socket
U24, U31: 74ALS32; DIP-14_W7.62mm_Socket
U25: 74ALS04; DIP-14_W7.62mm_Socket
U26: 74LS126; DIP-14_W7.62mm_Socket
U27, U28: GAL16V8; DIP-20_W7.62mm_Socket
U29: 74LS07; DIP-14_W7.62mm_Socket

Connections:
3st_buf: U26.4
+adr<0>: U24.2, U31.13
+adr<6>: U25.1
+adr<8>: U23.5 (E2)
+adr<9>: U23.1 (A0)
+adr<10>: U22.15, U23.2 (A1)
+adr<11>: U22.14, U23.3 (A2)
+adr<12>: U21.14, U31.2
+adr<13>: U21.13, U22.13
+adr<14>: U21.12, U22.12
+adr<15>: U21.11, U22.11, U27.1 (I1/CLK)
+adr<16>: U21.10, U22.10, U27.2 (I2)
+adr<17>: U21.7, U22.7, U27.3 (I3)
+adr<18>: U21.6, U22.6, U27.4 (I4)
+adr<19>: U21.5, U22.5, U27.5 (I5)
+adr<20>: U21.4, U22.4, U27.6 (I6)
+adr<21>: U21.3, U22.3, U27.7 (I7)
+adr<22>: U21.2, U22.2, U27.8 (I8)
+adr<23>: U21.1, U22.1, U24.9, U27.9 (I9)
+cttl: U28.1 (I1/CLK)
+ddin_buf: U25.8, U31.9, U31.12
+dma_req0: U25.13
+dma_req1: U25.11
+eprom_a15: U27.13 (IO7)
+mmu_a24: RR6.5 (R4)
+pav: U25.4
+swap_jumper: P22.14, RR6.8 (R7), U27.11 (I10/~OE)
+system_reset: U25.6
-adr<6>: U25.2
-cwait: RR6.10 (R9)
-dbe: U24.4, U24.10
-ddin: U25.9, U26.5
-ddin_buf: U26.6
-dma_cs: U31.3
-dma_cs1: U22.9, U31.1
-dma_req0: U25.12
-dma_req1: U25.10
-dram_cs: U27.15 (IO5)
-eprom_cs: U27.12 (IO8)
-hbe: U26.2
-hbe_buf: U24.12, U26.3, U31.10
-hlda: U26.1
-hold: RR6.4 (R3)
-int: RR6.3 (R2)
-io_cs: U21.9, U23.4 (E1), U24.5
-io_cs_fff0: U23.15 (O0)
-io_cs_fff2: U23.14 (O1)
-io_cs_fff4: U23.13 (O2)
-io_cs_fff6: U23.12 (O3)
-io_cs_fff8: U23.11 (O4)
-io_cs_fffa: U23.10 (O5)
-io_cs_fffc: U23.9 (O6)
-io_cs_fffe: U23.7 (O7)
-io_edata_oe: U24.6
-mem_data_oe: U24.8
-nmi: U28.12 (IO8)
-nmi_down: P22.3, RR6.7 (R6), SW2.3, U28.3 (I3)
-nmi_up: P22.1, RR6.6 (R5), SW2.1, U28.2 (I2)
-pav: RR6.9 (R8), U25.3
-rst_sw: P22.5
-spc: RR6.2 (R1)
-sram_cs: U27.14 (IO6)
-system_reset: U25.5
-tso: U28.4 (I4)
-we_h0: U31.8
-we_l0: U31.11
-wr: U24.1, U24.13
-wr_e: U24.3
-wr_o: U24.11
GND: C48.2, C49.2, C50.2, C51.2, C52.2, C55.2, P22.7, P22.13, SW2.2, U21.8 (GND), U22.8 (GND), U23.8 (GND), U24.7 (GND), U25.7 (GND), U26.7 (GND), U26.9, U26.10, U26.12, U26.13, U27.10 (GND), U28.10 (GND), U28.11 (I10/~OE), U29.3, U29.5, U29.9, U29.11, U29.13, U31.4, U31.5, U31.7 (GND)
VCC: C48.1, C49.1, C50.1, C51.1, C52.1, C55.1, P22.2, RR6.1 (common), U21.16 (VCC), U22.16 (VCC), U23.16 (VCC), U24.14 (VCC), U25.14 (VCC), U26.14 (VCC), U27.20 (VCC), U28.20 (VCC), U31.14 (VCC)
io_decode1: U21.15
io_decode2: U23.6 (E3)

Notes on the sheet:
expansion
scsi -dack
low for 0xffecxx
Unused Gates
scsi -cs
tied high RR8 pin 10
nmipal
I/O Decode
DMA Decode
memcspal
tied high RR8 pin 9
icu
invert_1
low for 0xfffxxx
io_decode1
or_2
nmi_sw
io_decode2
3st_buf1
Note: was U29 sw_header
Note: P22 13 & 14 (+swap_jumper) toggles location of EEPROM in memory for dual boot strap option
tied high RR7 pin8
or_1
dma_decode
floppy controller
uarts
