lynchaj/NS32016-BC/IO.kicad_sch

## KiCad design IO.kicad_sch (2024-06-16)

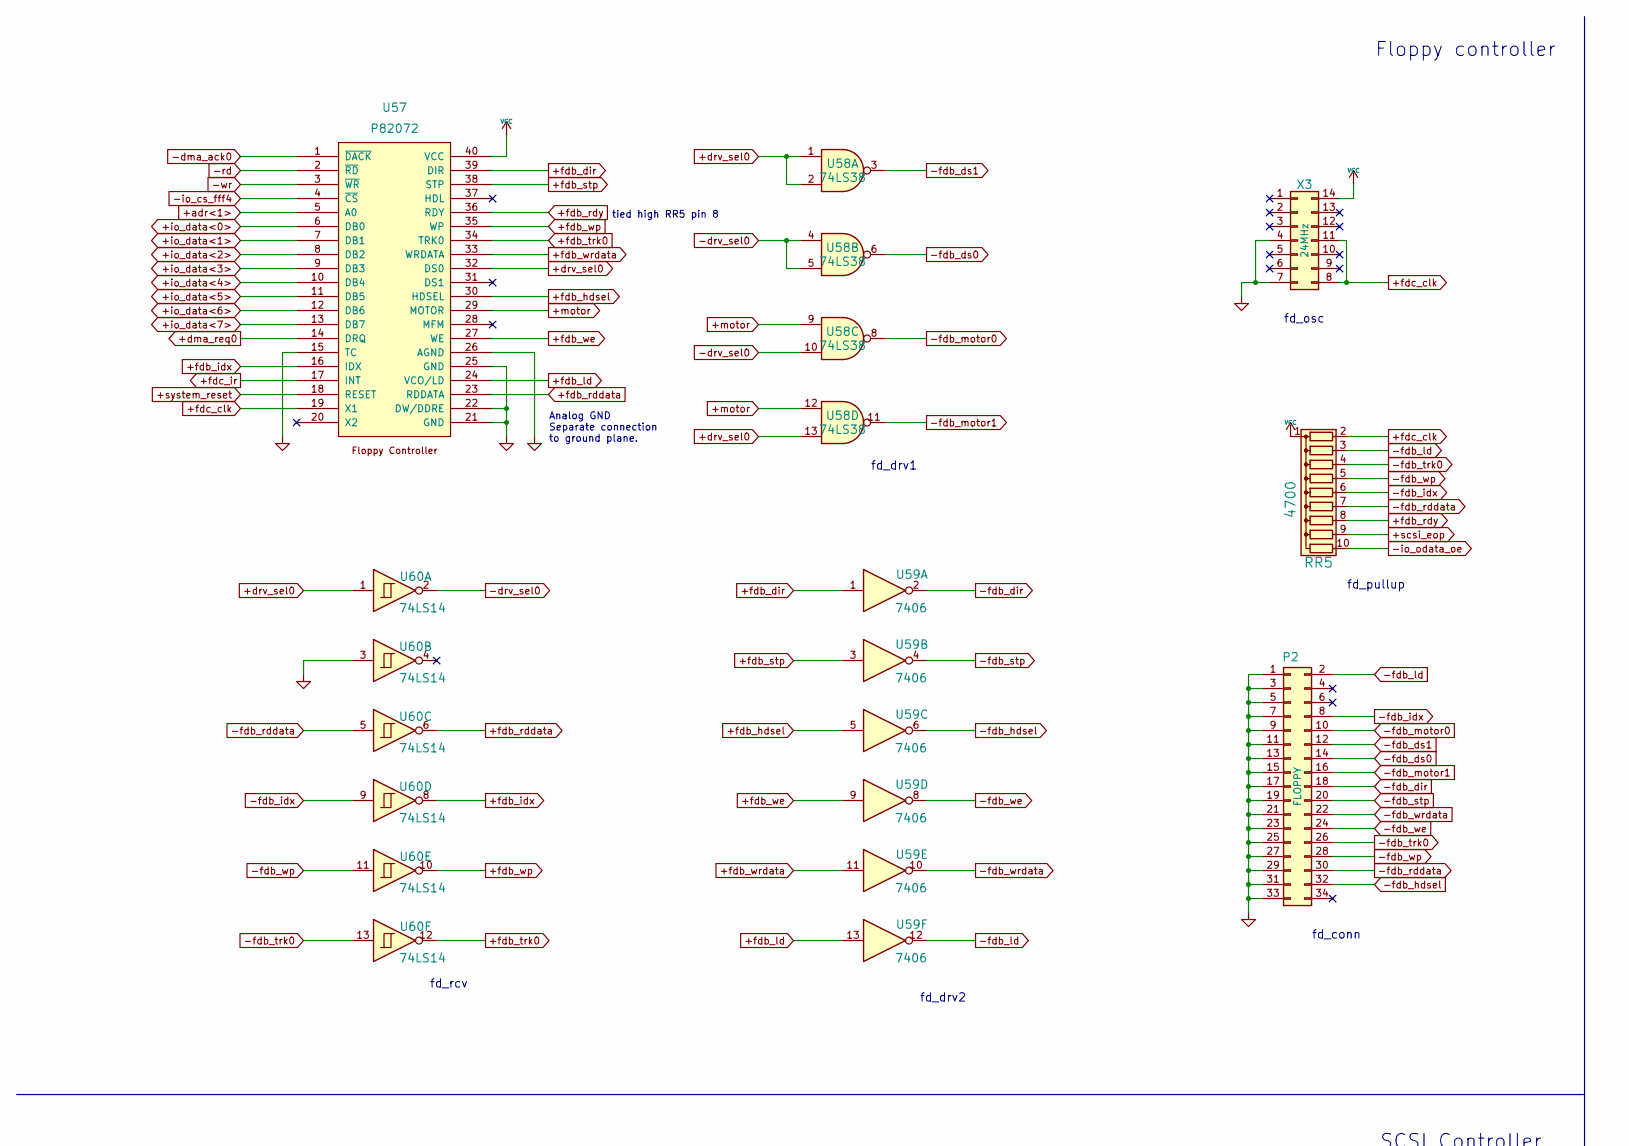
[picture p27: schematic IO.kicad_sch, part in row 1, column 1]

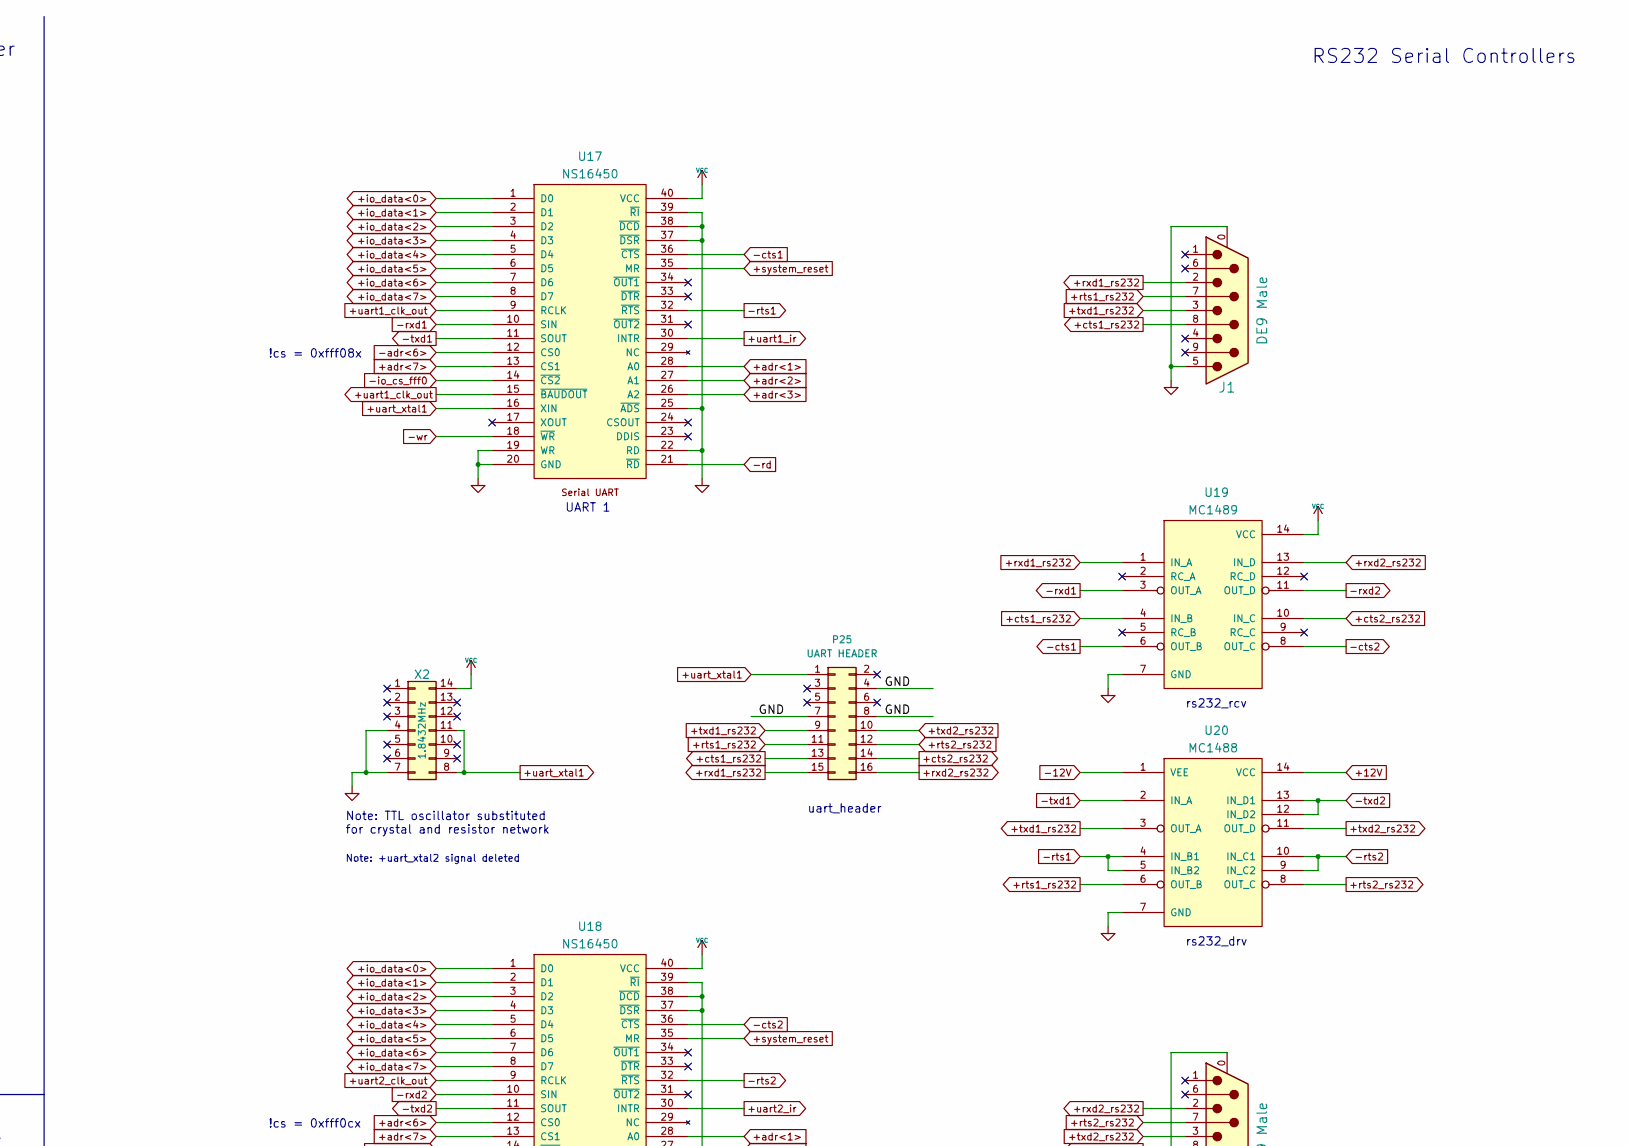
[picture p28: schematic IO.kicad_sch, part in row 1, column 2]

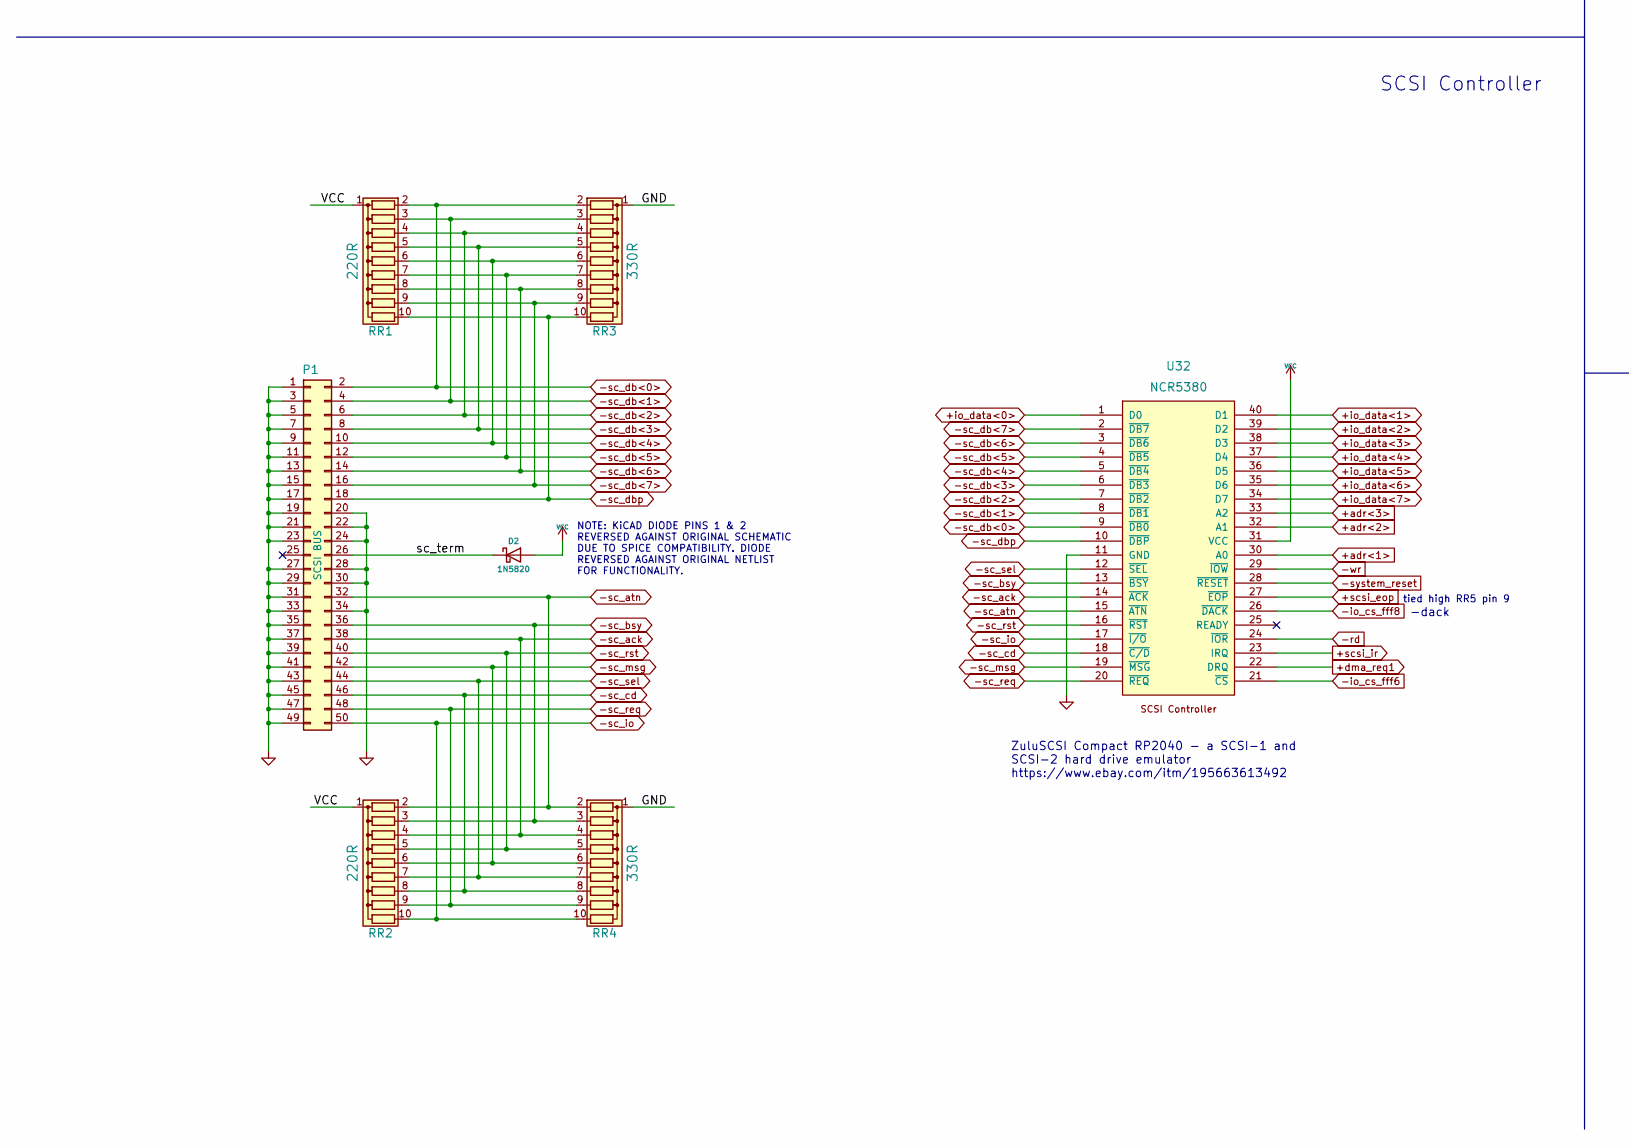
[picture p29: schematic IO.kicad_sch, part in row 2, column 1]

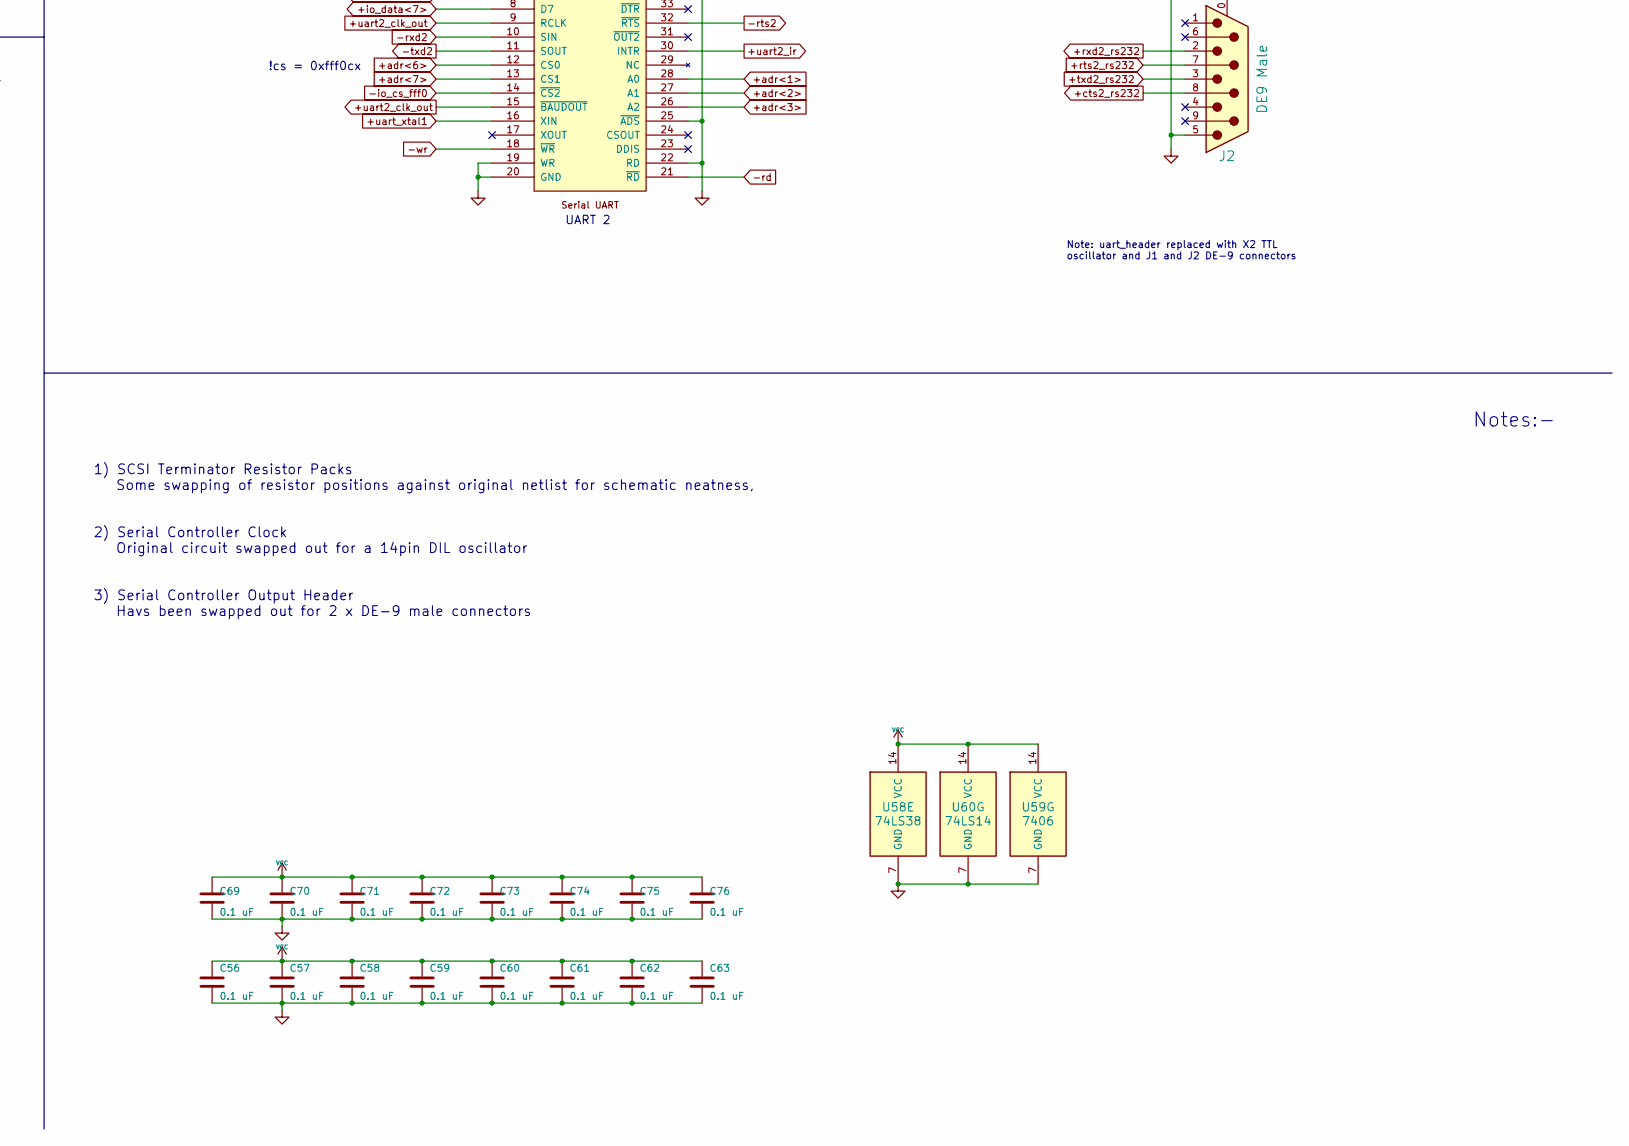
[picture p30: schematic IO.kicad_sch, part in row 2, column 2]

Parts:
C56, C57, C58, C59, C60, C61, C62, C63, C69, C70, C71, C72, C73, C74, C75, C76: 0.1 uF; C_Rect_L7.0mm_W2.5mm_P5.00mm
D2: 1N5820; D_DO-201AD_P15.24mm_Horizontal
J1, J2: DE9 Male; DSUB-9_Male_Horizontal_P2.77x2.84mm_EdgePinOffset4.94mm_Hou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
P1: SCSI BUS; PinHeader_2x25_P2.54mm_Vertical
P2: FLOPPY; PinHeader_2x17_P2.54mm_Vertical
P25: UART HEADER; PinHeader_2x08_P2.54mm_Vertical
RR1, RR2: 220R; R_Array_SIP10
RR3, RR4: 330R; R_Array_SIP10
RR5: 4700; R_Array_SIP10
U17, U18: NS16450; DIP-40_W15.24mm_Socket
U19: MC1489; DIP-14_W7.62mm_Socket
U20: MC1488; DIP-14_W7.62mm_Socket
U32: NCR5380; DIP-40_W15.24mm_Socket
U57: P82072; DIP-40_W15.24mm_Socket
U58: 74LS38; DIP-14_W7.62mm_Socket
U59: 7406; DIP-14_W7.62mm_Socket
U60: 74LS14; DIP-14_W7.62mm_Socket
X2: 1.8432MHz; DIP-14_W7.62mm_Socket
X3: 24MHz; DIP-14_W7.62mm_Socket

Connections:
+12V: U20.14 (VCC)
+adr<1>: U17.28 (A0), U18.28 (A0), U32.30 (A0), U57.5 (A0)
+adr<2>: U17.27 (A1), U18.27 (A1), U32.32 (A1)
+adr<3>: U17.26 (A2), U18.26 (A2), U32.33 (A2)
+adr<6>: U18.12 (CS0)
+adr<7>: U17.13 (CS1), U18.13 (CS1)
+cts1_rs232: J1.8, P25.13, U19.4 (IN_B)
+cts2_rs232: J2.8, P25.14, U19.10 (IN_C)
+dma_req0: U57.14 (DRQ)
+dma_req1: U32.22 (DRQ)
+drv_sel0: U57.32 (DS0), U58.1, U58.2, U58.13, U60.1
+fdb_dir: U57.39 (DIR), U59.1
+fdb_hdsel: U57.30 (HDSEL), U59.5
+fdb_idx: U57.16 (IDX), U60.8
+fdb_ld: U57.24 (VCO/LD), U59.13
+fdb_rddata: U57.23 (RDDATA), U60.6
+fdb_rdy: RR5.8 (R7), U57.36 (RDY)
+fdb_stp: U57.38 (STP), U59.3
+fdb_trk0: U57.34 (TRK0), U60.12
+fdb_we: U57.27 (WE), U59.9
+fdb_wp: U57.35 (WP), U60.10
+fdb_wrdata: U57.33 (WRDATA), U59.11
+fdc_clk: RR5.2 (R1), U57.19 (X1), X3.8, X3.11
+fdc_ir: U57.17 (INT)
+io_data<0>: U17.1 (D0), U18.1 (D0), U32.1 (D0), U57.6 (DB0)
+io_data<1>: U17.2 (D1), U18.2 (D1), U32.40 (D1), U57.7 (DB1)
+io_data<2>: U17.3 (D2), U18.3 (D2), U32.39 (D2), U57.8 (DB2)
+io_data<3>: U17.4 (D3), U18.4 (D3), U32.38 (D3), U57.9 (DB3)
+io_data<4>: U17.5 (D4), U18.5 (D4), U32.37 (D4), U57.10 (DB4)
+io_data<5>: U17.6 (D5), U18.6 (D5), U32.36 (D5), U57.11 (DB5)
+io_data<6>: U17.7 (D6), U18.7 (D6), U32.35 (D6), U57.12 (DB6)
+io_data<7>: U17.8 (D7), U18.8 (D7), U32.34 (D7), U57.13 (DB7)
+motor: U57.29 (MOTOR), U58.9, U58.12
+rts1_rs232: J1.7, P25.11, U20.6 (OUT_B)
+rts2_rs232: J2.7, P25.12, U20.8 (OUT_C)
+rxd1_rs232: J1.2, P25.15, U19.1 (IN_A)
+rxd2_rs232: J2.2, P25.16, U19.13 (IN_D)
+scsi_eop: RR5.9 (R8), U32.27 (~EOP)
+scsi_ir: U32.23 (IRQ)
+system_reset: U17.35 (MR), U18.35 (MR), U57.18 (RESET)
+txd1_rs232: J1.3, P25.9, U20.3 (OUT_A)
+txd2_rs232: J2.3, P25.10, U20.11 (OUT_D)
+uart1_clk_out: U17.9 (RCLK), U17.15 (~BAUDOUT)
+uart1_ir: U17.30 (INTR)
+uart2_clk_out: U18.9 (RCLK), U18.15 (~BAUDOUT)
+uart2_ir: U18.30 (INTR)
+uart_xtal1: P25.1, U17.16 (XIN), U18.16 (XIN), X2.8, X2.11
-12V: U20.1 (VEE)
-adr<6>: U17.12 (CS0)
-cts1: U17.36 (~CTS), U19.6 (OUT_B)
-cts2: U18.36 (~CTS), U19.8 (OUT_C)
-dma_ack0: U57.1 (~DACK)
-drv_sel0: U58.4, U58.5, U58.10, U60.2
-fdb_dir: P2.18, U59.2
-fdb_ds0: P2.14, U58.6
-fdb_ds1: P2.12, U58.3
-fdb_hdsel: P2.32, U59.6
-fdb_idx: P2.8, RR5.6 (R5), U60.9
-fdb_ld: P2.2, RR5.3 (R2), U59.12
-fdb_motor0: P2.10, U58.8
-fdb_motor1: P2.16, U58.11
-fdb_rddata: P2.30, RR5.7 (R6), U60.5
-fdb_stp: P2.20, U59.4
-fdb_trk0: P2.26, RR5.4 (R3), U60.13
-fdb_we: P2.24, U59.8
-fdb_wp: P2.28, RR5.5 (R4), U60.11
-fdb_wrdata: P2.22, U59.10
-io_cs_fff0: U17.14 (~CS2), U18.14 (~CS2)
-io_cs_fff4: U57.4 (~CS)
-io_cs_fff6: U32.21 (~CS)
-io_cs_fff8: U32.26 (~DACK)
-io_odata_oe: RR5.10 (R9)
-rd: U17.21 (~RD), U18.21 (~RD), U32.24 (~IOR), U57.2 (~RD)
-rts1: U17.32 (~RTS), U20.4 (IN_B1), U20.5 (IN_B2)
-rts2: U18.32 (~RTS), U20.9 (IN_C2), U20.10 (IN_C1)
-rxd1: U17.10 (SIN), U19.3 (OUT_A)
-rxd2: U18.10 (SIN), U19.11 (OUT_D)
-sc_ack: P1.38, RR2.4 (R3), RR4.4 (R3), U32.14 (~ACK)
-sc_atn: P1.32, RR2.2 (R1), RR4.2 (R1), U32.15 (~ATN)
-sc_bsy: P1.36, RR2.3 (R2), RR4.3 (R2), U32.13 (~BSY)
-sc_cd: P1.46, RR2.8 (R7), RR4.8 (R7), U32.18 (~C/D)
-sc_db<0>: P1.2, RR1.2 (R1), RR3.2 (R1), U32.9 (~DB0)
-sc_db<1>: P1.4, RR1.3 (R2), RR3.3 (R2), U32.8 (~DB1)
-sc_db<2>: P1.6, RR1.4 (R3), RR3.4 (R3), U32.7 (~DB2)
-sc_db<3>: P1.8, RR1.5 (R4), RR3.5 (R4), U32.6 (~DB3)
-sc_db<4>: P1.10, RR1.6 (R5), RR3.6 (R5), U32.5 (~DB4)
-sc_db<5>: P1.12, RR1.7 (R6), RR3.7 (R6), U32.4 (~DB5)
-sc_db<6>: P1.14, RR1.8 (R7), RR3.8 (R7), U32.3 (~DB6)
-sc_db<7>: P1.16, RR1.9 (R8), RR3.9 (R8), U32.2 (~DB7)
-sc_dbp: P1.18, RR1.10 (R9), RR3.10 (R9), U32.10 (~DBP)
-sc_io: P1.50, RR2.10 (R9), RR4.10 (R9), U32.17 (~I/O)
-sc_msg: P1.42, RR2.6 (R5), RR4.6 (R5), U32.19 (~MSG)
-sc_req: P1.48, RR2.9 (R8), RR4.9 (R8), U32.20 (~REQ)
-sc_rst: P1.40, RR2.5 (R4), RR4.5 (R4), U32.16 (~RST)
-sc_sel: P1.44, RR2.7 (R6), RR4.7 (R6), U32.12 (~SEL)
-system_reset: U32.28 (~RESET)
-txd1: U17.11 (SOUT), U20.2 (IN_A)
-txd2: U18.11 (SOUT), U20.12 (IN_D2), U20.13 (IN_D1)
-wr: U17.18 (~WR), U18.18 (~WR), U32.29 (~IOW), U57.3 (~WR)
GND: C56.2, C57.2, C58.2, C59.2, C60.2, C61.2, C62.2, C63.2, C69.2, C70.2, C71.2, C72.2, C73.2, C74.2, C75.2, C76.2, J1.0 (PAD), J1.5, J2.0 (PAD), J2.5, P1.1, P1.3, P1.5, P1.7, P1.9, P1.11, P1.13, P1.15, P1.17, P1.19, P1.20, P1.21, P1.22, P1.23, P1.24, P1.27, P1.28, P1.29, P1.30, P1.31, P1.33, P1.34, P1.35, P1.37, P1.39, P1.41, P1.43, P1.45, P1.47, P1.49, P2.1, P2.3, P2.5, P2.7, P2.9, P2.11, P2.13, P2.15, P2.17, P2.19, P2.21, P2.23, P2.25, P2.27, P2.29, P2.31, P2.33, P25.4, P25.7, P25.8, RR3.1 (common), RR4.1 (common), U17.19 (WR), U17.20 (GND), U17.22 (RD), U17.25 (~ADS), U17.37 (~DSR), U17.38 (~DCD), U17.39 (~RI), U18.19 (WR), U18.20 (GND), U18.22 (RD), U18.25 (~ADS), U18.37 (~DSR), U18.38 (~DCD), U18.39 (~RI), U19.7 (GND), U20.7 (GND), U32.11 (GND), U57.15 (TC), U57.21 (GND), U57.22 (DW/DDRE), U57.25 (GND), U57.26 (AGND), U58.7 (GND), U59.7 (GND), U60.3, U60.7 (GND), X2.4, X2.7, X3.4, X3.7
VCC: C56.1, C57.1, C58.1, C59.1, C60.1, C61.1, C62.1, C63.1, C69.1, C70.1, C71.1, C72.1, C73.1, C74.1, C75.1, C76.1, D2.2 (A), RR1.1 (common), RR2.1 (common), RR5.1 (common), U17.40 (VCC), U18.40 (VCC), U19.14 (VCC), U32.31 (VCC), U57.40 (VCC), U58.14 (VCC), U59.14 (VCC), U60.14 (VCC), X2.14, X3.14
sc_term: D2.1 (K), P1.26

Notes on the sheet:
tied high RR5 pin 8
Note: uart_header replaced with X2 TTL oscillator and J1 and J2 DE-9 connectors
Notes:-
!cs = 0xfff08x
UART 2
rs232_drv
uart_header
3) Serial Controller Output Header Havs been swapped out for 2 x DE-9 male connectors
fd_drv1
RS232 Serial Controllers
UART 1
fd_drv2
fd_pullup
NOTE: KiCAD DIODE PINS 1 & 2 REVERSED AGAINST ORIGINAL SCHEMATIC DUE TO SPICE COMPATIBILITY. DIODE REVERSED AGAINST ORIGINAL NETLIST FOR FUNCTIONALITY.
fd_osc
tied high RR5 pin 9
fd_rcv
1) SCSI Terminator Resistor Packs Some swapping of resistor positions against original netlist for schematic neatness,
Note: +uart_xtal2 signal deleted
2) Serial Controller Clock Original circuit swapped out for a 14pin DIL oscillator
Note: TTL oscillator substituted for crystal and resistor network
fd_conn
rs232_rcv
-dack
Floppy controller
Analog GND Separate connection to ground plane.
SCSI Controller
ZuluSCSI Compact RP2040 - a SCSI-1 and SCSI-2 hard drive emulator https://www.ebay.com/itm/195663613492
!cs = 0xfff0cx
