lynchaj/NS32016-BC/NS32016-BC.kicad_sch

## KiCad design NS32016-BC.kicad_sch (2024-06-16)

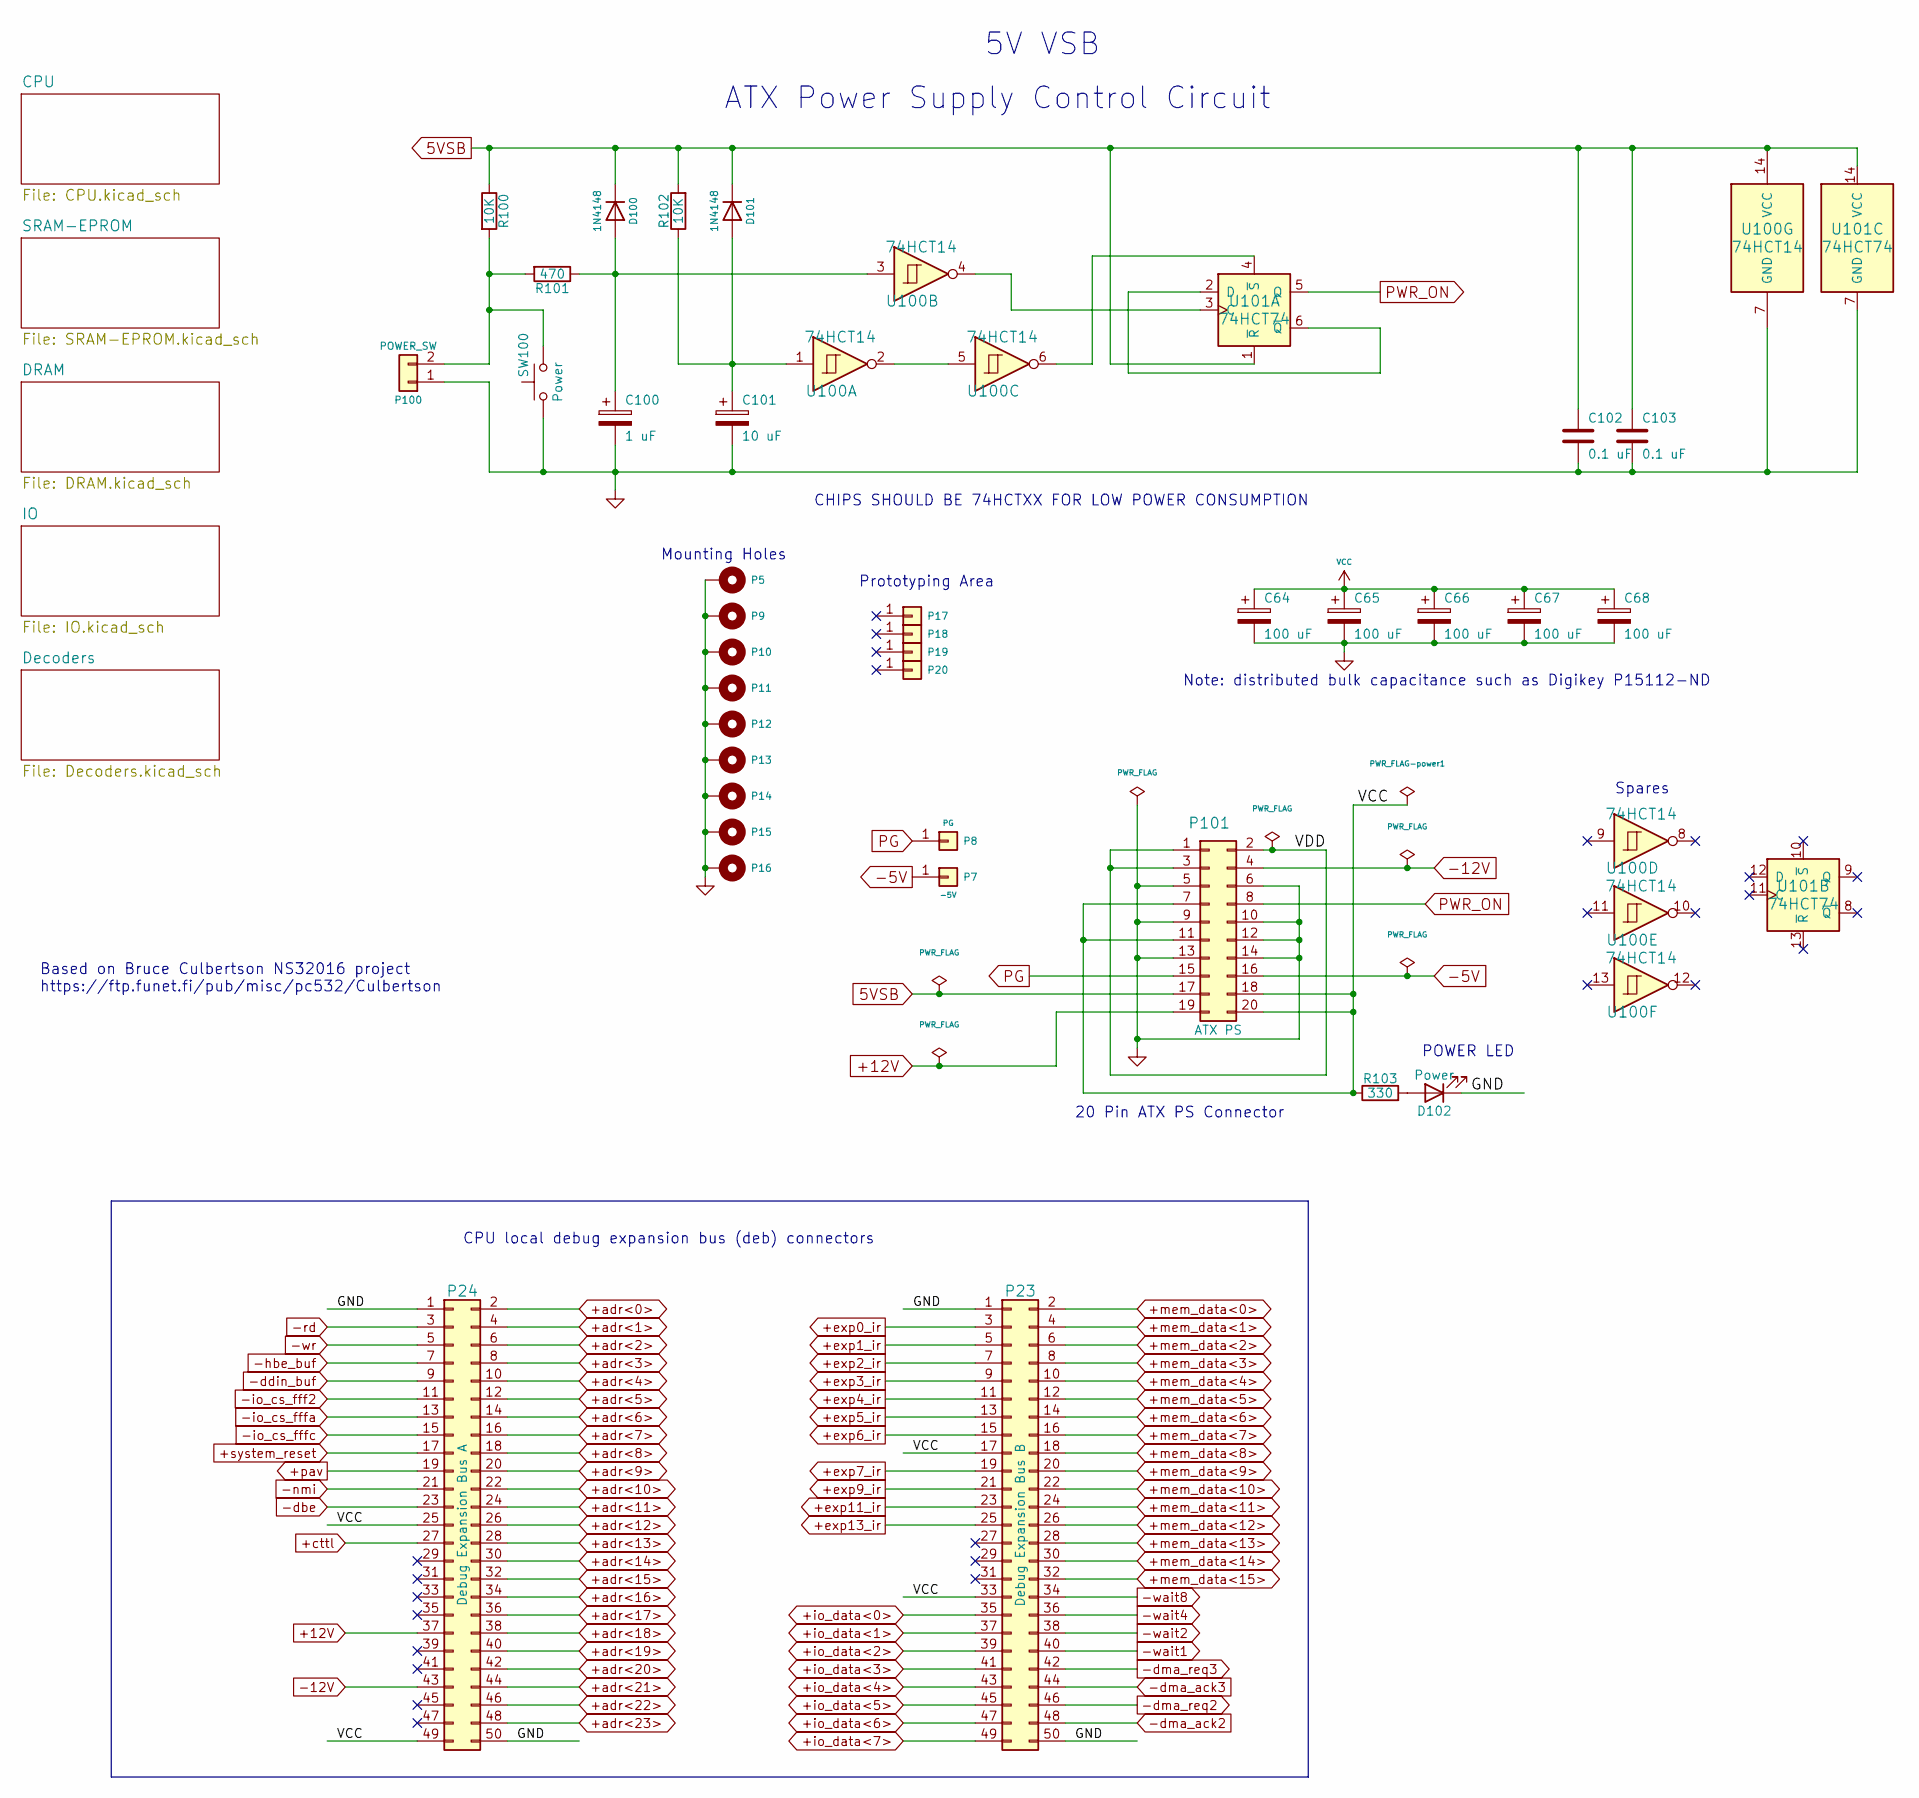
[picture p31: schematic NS32016-BC.kicad_sch]

Parts:
C64, C65, C66, C67, C68: 100 uF; CP_Radial_D5.0mm_P2.50mm
C100: 1 uF; CP_Radial_D5.0mm_P2.50mm
C101: 10 uF; CP_Radial_D5.0mm_P2.50mm
C102, C103: 0.1 uF; C_Rect_L7.0mm_W2.5mm_P5.00mm
D100, D101: 1N4148; D_DO-35_SOD27_P7.62mm_Horizontal
D102: Power; LED_D5.0mm
P5, P9, P10, P11, P12, P13, P14, P15, P16: CONN_1; MountingHole_4.3mm_M4_DIN965_Pad
P7: -5V; PinHeader_1x01_P2.54mm_Vertical
P8: PG; PinHeader_1x01_P2.54mm_Vertical
P17, P18, P19, P20: CONN_1; PGA15X15
P23: Debug Expansion Bus B; PinHeader_2x25_P2.54mm_Vertical
P24: Debug Expansion Bus A; PinHeader_2x25_P2.54mm_Vertical
P100: POWER_SW; PinHeader_1x02_P2.54mm_Vertical
P101: ATX PS; ATX_NON_90DEG
R100, R102: 10K; R_Axial_DIN0204_L3.6mm_D1.6mm_P7.62mm_Horizontal
R101: 470; R_Axial_DIN0204_L3.6mm_D1.6mm_P7.62mm_Horizontal
R103: 330; R_Axial_DIN0204_L3.6mm_D1.6mm_P7.62mm_Horizontal
SW100: Power; SW_PUSH_6mm
U100: 74HCT14; DIP-14_W7.62mm_Socket
U101: 74HCT74; DIP-14_W7.62mm_Socket

Connections:
5VSB: C102.1, C103.1, D100.1 (K), D101.1 (K), P101.17, R100.1, R102.2, U100.14 (VCC), U101.1 (~R), U101.14 (VCC)
+12V: P24.37, P101.19
+adr<0>: P24.2
+adr<1>: P24.4
+adr<2>: P24.6
+adr<3>: P24.8
+adr<4>: P24.10
+adr<5>: P24.12
+adr<6>: P24.14
+adr<7>: P24.16
+adr<8>: P24.18
+adr<9>: P24.20
+adr<10>: P24.22
+adr<11>: P24.24
+adr<12>: P24.26
+adr<13>: P24.28
+adr<14>: P24.30
+adr<15>: P24.32
+adr<16>: P24.34
+adr<17>: P24.36
+adr<18>: P24.38
+adr<19>: P24.40
+adr<20>: P24.42
+adr<21>: P24.44
+adr<22>: P24.46
+adr<23>: P24.48
+cttl: P24.27
+exp0_ir: P23.3
+exp1_ir: P23.5
+exp2_ir: P23.7
+exp3_ir: P23.9
+exp4_ir: P23.11
+exp5_ir: P23.13
+exp6_ir: P23.15
+exp7_ir: P23.19
+exp9_ir: P23.21
+exp11_ir: P23.23
+exp13_ir: P23.25
+io_data<0>: P23.35
+io_data<1>: P23.37
+io_data<2>: P23.39
+io_data<3>: P23.41
+io_data<4>: P23.43
+io_data<5>: P23.45
+io_data<6>: P23.47
+io_data<7>: P23.49
+mem_data<0>: P23.2
+mem_data<1>: P23.4
+mem_data<2>: P23.6
+mem_data<3>: P23.8
+mem_data<4>: P23.10
+mem_data<5>: P23.12
+mem_data<6>: P23.14
+mem_data<7>: P23.16
+mem_data<8>: P23.18
+mem_data<9>: P23.20
+mem_data<10>: P23.22
+mem_data<11>: P23.24
+mem_data<12>: P23.26
+mem_data<13>: P23.28
+mem_data<14>: P23.30
+mem_data<15>: P23.32
+pav: P24.19
+system_reset: P24.17
-5V: P7.1, P101.16
-12V: P24.43, P101.4
-dbe: P24.23
-ddin_buf: P24.9
-dma_ack2: P23.48
-dma_ack3: P23.44
-dma_req2: P23.46
-dma_req3: P23.42
-hbe_buf: P24.7
-io_cs_fff2: P24.11
-io_cs_fffa: P24.13
-io_cs_fffc: P24.15
-nmi: P24.21
-rd: P24.3
-wait1: P23.40
-wait2: P23.38
-wait4: P23.36
-wait8: P23.34
-wr: P24.5
GND: C100.2, C101.2, C102.2, C103.2, D102.1 (K), P5.1, P9.1, P10.1, P11.1, P12.1, P13.1, P14.1, P15.1, P16.1, P23.1, P23.50, P24.1, P24.50, P100.1, P101.5, P101.6, P101.9, P101.10, P101.12, P101.13, P101.14, SW100.1, U100.7 (GND), U101.7 (GND)
GND-power1: C64.2, C65.2, C66.2, C67.2, C68.2
unnamed: C100.1, D100.2 (A), R101.1, U100.3
unnamed: C101.1, D101.2 (A), R102.1, U100.1
unnamed: D102.2 (A), R103.2
unnamed: P100.2, R100.2, R101.2, SW100.2
unnamed: U100.2, U100.5
unnamed: U100.4, U101.3 (C)
unnamed: U100.6, U101.4 (~S)
unnamed: U101.2 (D), U101.6 (~Q)
PG: P8.1, P101.15
PWR_ON: P101.8, U101.5 (Q)
VCC: C64.1, C65.1, C66.1, C67.1, C68.1, P23.17, P23.33, P24.25, P24.49, P101.7, P101.11, P101.18, P101.20, R103.1
VDD: P101.1, P101.2, P101.3

Notes on the sheet:
Prototyping Area
Based on Bruce Culbertson NS32016 project https://ftp.funet.fi/pub/misc/pc532/Culbertson
Spares
Note: distributed bulk capacitance such as Digikey P15112-ND
5V VSB
ATX Power Supply Control Circuit
20 Pin ATX PS Connector
POWER LED
CHIPS SHOULD BE 74HCTXX FOR LOW POWER CONSUMPTION
CPU local debug expansion bus (deb) connectors
Mounting Holes
