lynchaj/NS32016-BC/SRAM-EPROM.kicad_sch

## KiCad design SRAM-EPROM.kicad_sch (2024-06-16)

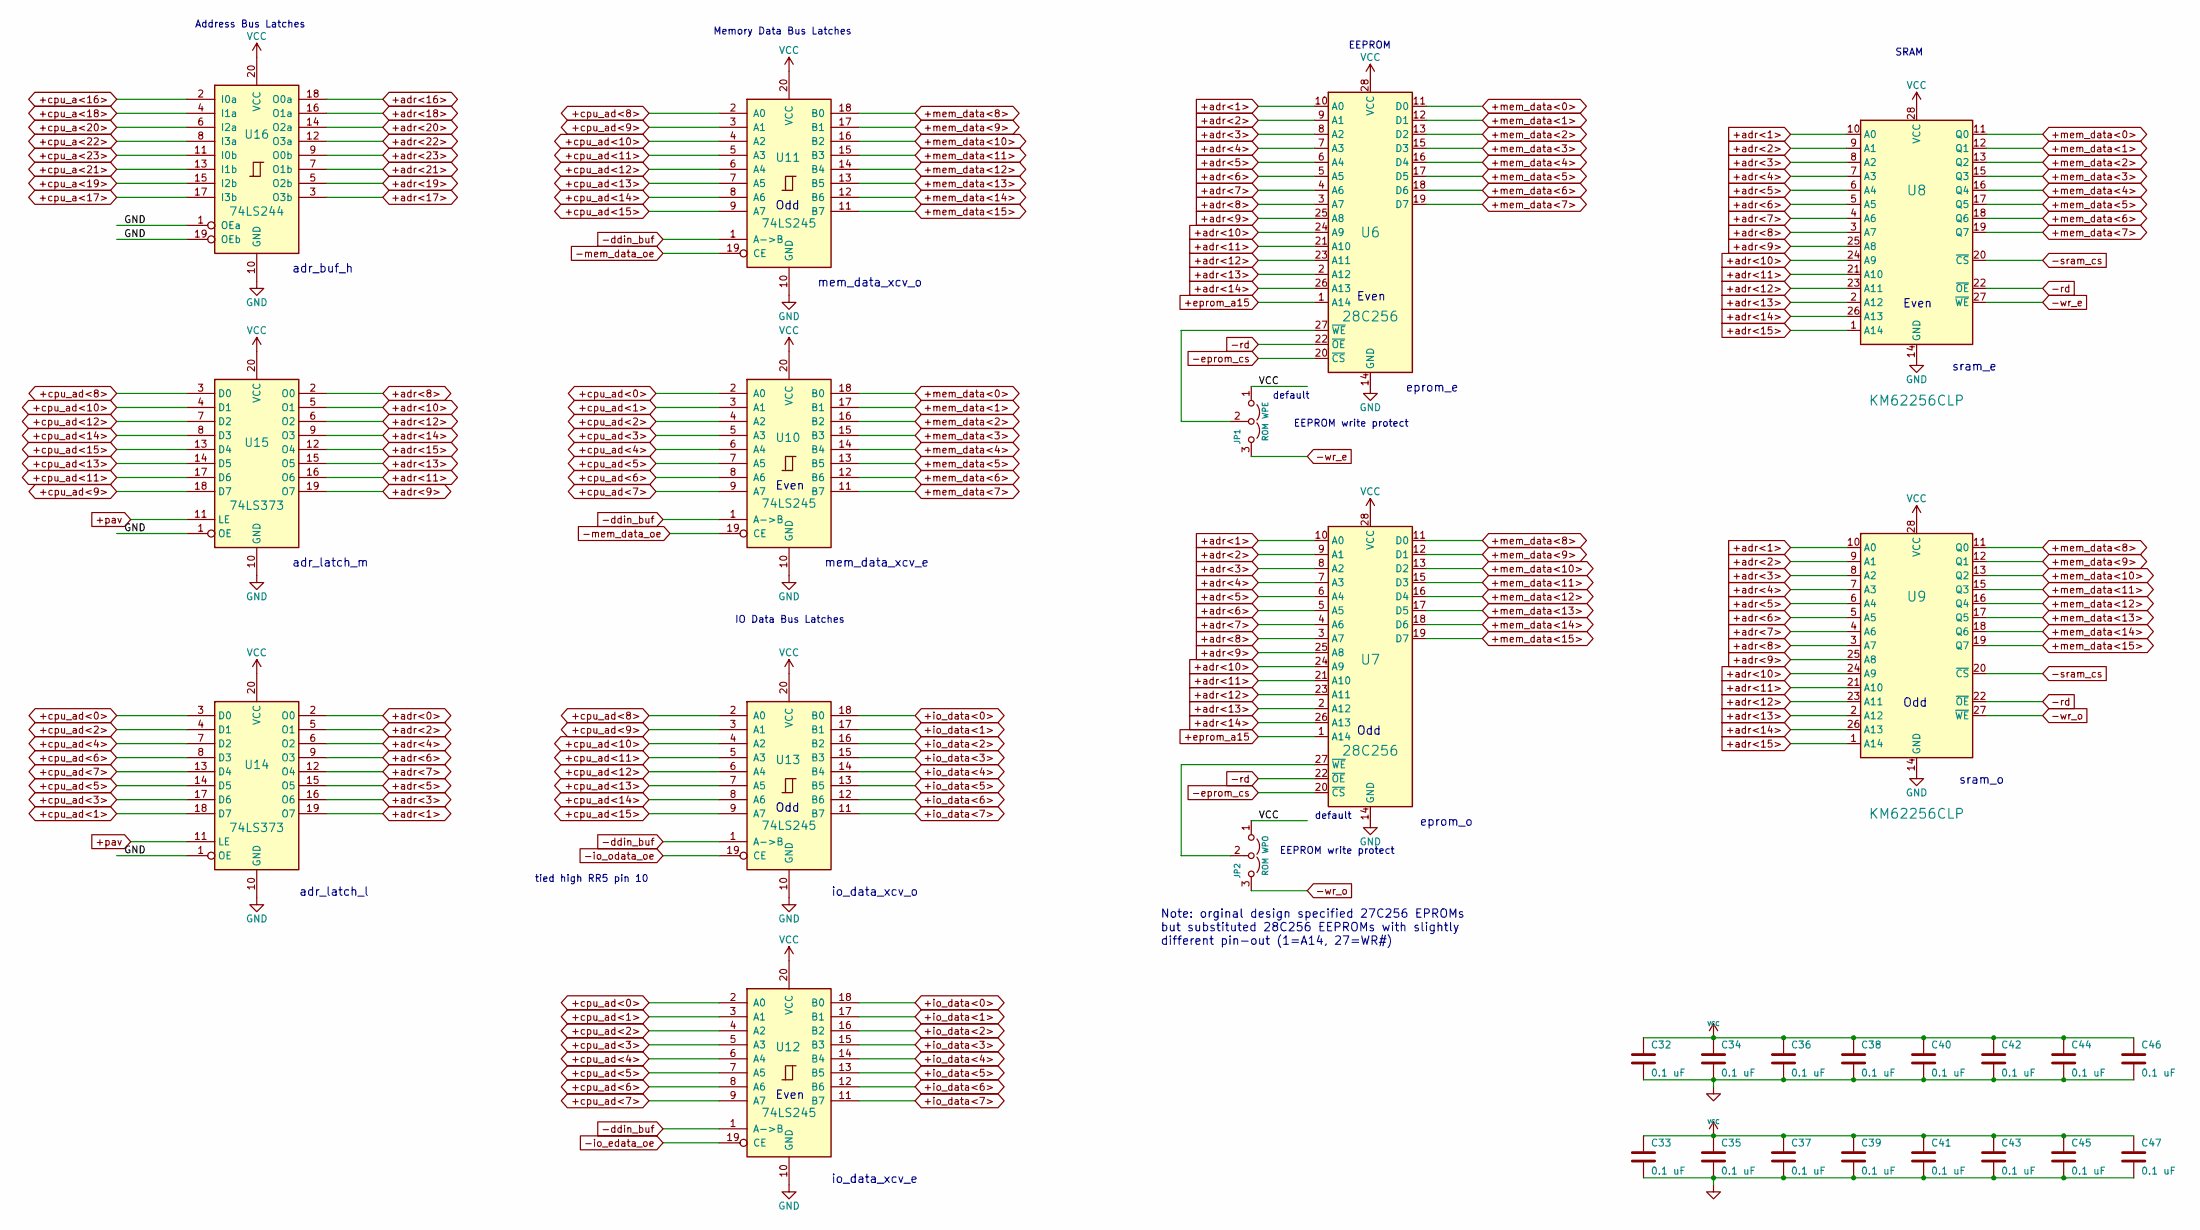
[picture p32: schematic SRAM-EPROM.kicad_sch]

Parts:
C32, C33, C34, C35, C36, C37, C38, C39, C40, C41, C42, C43, C44, C45, C46, C47: 0.1 uF; C_Rect_L7.0mm_W2.5mm_P5.00mm
JP1: ROM WPE; PinHeader_1x03_P2.54mm_Vertical
JP2: ROM WPO; PinHeader_1x03_P2.54mm_Vertical
U6, U7: 28C256; DIP-28_W15.24mm_Socket
U8, U9: KM62256CLP; DIP-28_W15.24mm_Socket
U10, U11, U12, U13: 74LS245; DIP-20_W7.62mm_Socket
U14, U15: 74LS373; DIP-20_W7.62mm_Socket
U16: 74LS244; DIP-20_W7.62mm_Socket

Connections:
+adr<0>: U14.2 (O0)
+adr<1>: U6.10 (A0), U7.10 (A0), U8.10 (A0), U9.10 (A0), U14.19 (O7)
+adr<2>: U6.9 (A1), U7.9 (A1), U8.9 (A1), U9.9 (A1), U14.5 (O1)
+adr<3>: U6.8 (A2), U7.8 (A2), U8.8 (A2), U9.8 (A2), U14.16 (O6)
+adr<4>: U6.7 (A3), U7.7 (A3), U8.7 (A3), U9.7 (A3), U14.6 (O2)
+adr<5>: U6.6 (A4), U7.6 (A4), U8.6 (A4), U9.6 (A4), U14.15 (O5)
+adr<6>: U6.5 (A5), U7.5 (A5), U8.5 (A5), U9.5 (A5), U14.9 (O3)
+adr<7>: U6.4 (A6), U7.4 (A6), U8.4 (A6), U9.4 (A6), U14.12 (O4)
+adr<8>: U6.3 (A7), U7.3 (A7), U8.3 (A7), U9.3 (A7), U15.2 (O0)
+adr<9>: U6.25 (A8), U7.25 (A8), U8.25 (A8), U9.25 (A8), U15.19 (O7)
+adr<10>: U6.24 (A9), U7.24 (A9), U8.24 (A9), U9.24 (A9), U15.5 (O1)
+adr<11>: U6.21 (A10), U7.21 (A10), U8.21 (A10), U9.21 (A10), U15.16 (O6)
+adr<12>: U6.23 (A11), U7.23 (A11), U8.23 (A11), U9.23 (A11), U15.6 (O2)
+adr<13>: U6.2 (A12), U7.2 (A12), U8.2 (A12), U9.2 (A12), U15.15 (O5)
+adr<14>: U6.26 (A13), U7.26 (A13), U8.26 (A13), U9.26 (A13), U15.9 (O3)
+adr<15>: U8.1 (A14), U9.1 (A14), U15.12 (O4)
+adr<16>: U16.18 (O0a)
+adr<17>: U16.3 (O3b)
+adr<18>: U16.16 (O1a)
+adr<19>: U16.5 (O2b)
+adr<20>: U16.14 (O2a)
+adr<21>: U16.7 (O1b)
+adr<22>: U16.12 (O3a)
+adr<23>: U16.9 (O0b)
+cpu_a<16>: U16.2 (I0a)
+cpu_a<17>: U16.17 (I3b)
+cpu_a<18>: U16.4 (I1a)
+cpu_a<19>: U16.15 (I2b)
+cpu_a<20>: U16.6 (I2a)
+cpu_a<21>: U16.13 (I1b)
+cpu_a<22>: U16.8 (I3a)
+cpu_a<23>: U16.11 (I0b)
+cpu_ad<0>: U10.2 (A0), U12.2 (A0), U14.3 (D0)
+cpu_ad<1>: U10.3 (A1), U12.3 (A1), U14.18 (D7)
+cpu_ad<2>: U10.4 (A2), U12.4 (A2), U14.4 (D1)
+cpu_ad<3>: U10.5 (A3), U12.5 (A3), U14.17 (D6)
+cpu_ad<4>: U10.6 (A4), U12.6 (A4), U14.7 (D2)
+cpu_ad<5>: U10.7 (A5), U12.7 (A5), U14.14 (D5)
+cpu_ad<6>: U10.8 (A6), U12.8 (A6), U14.8 (D3)
+cpu_ad<7>: U10.9 (A7), U12.9 (A7), U14.13 (D4)
+cpu_ad<8>: U11.2 (A0), U13.2 (A0), U15.3 (D0)
+cpu_ad<9>: U11.3 (A1), U13.3 (A1), U15.18 (D7)
+cpu_ad<10>: U11.4 (A2), U13.4 (A2), U15.4 (D1)
+cpu_ad<11>: U11.5 (A3), U13.5 (A3), U15.17 (D6)
+cpu_ad<12>: U11.6 (A4), U13.6 (A4), U15.7 (D2)
+cpu_ad<13>: U11.7 (A5), U13.7 (A5), U15.14 (D5)
+cpu_ad<14>: U11.8 (A6), U13.8 (A6), U15.8 (D3)
+cpu_ad<15>: U11.9 (A7), U13.9 (A7), U15.13 (D4)
+eprom_a15: U6.1 (A14), U7.1 (A14)
+io_data<0>: U12.18 (B0), U13.18 (B0)
+io_data<1>: U12.17 (B1), U13.17 (B1)
+io_data<2>: U12.16 (B2), U13.16 (B2)
+io_data<3>: U12.15 (B3), U13.15 (B3)
+io_data<4>: U12.14 (B4), U13.14 (B4)
+io_data<5>: U12.13 (B5), U13.13 (B5)
+io_data<6>: U12.12 (B6), U13.12 (B6)
+io_data<7>: U12.11 (B7), U13.11 (B7)
+mem_data<0>: U6.11 (D0), U8.11 (Q0), U10.18 (B0)
+mem_data<1>: U6.12 (D1), U8.12 (Q1), U10.17 (B1)
+mem_data<2>: U6.13 (D2), U8.13 (Q2), U10.16 (B2)
+mem_data<3>: U6.15 (D3), U8.15 (Q3), U10.15 (B3)
+mem_data<4>: U6.16 (D4), U8.16 (Q4), U10.14 (B4)
+mem_data<5>: U6.17 (D5), U8.17 (Q5), U10.13 (B5)
+mem_data<6>: U6.18 (D6), U8.18 (Q6), U10.12 (B6)
+mem_data<7>: U6.19 (D7), U8.19 (Q7), U10.11 (B7)
+mem_data<8>: U7.11 (D0), U9.11 (Q0), U11.18 (B0)
+mem_data<9>: U7.12 (D1), U9.12 (Q1), U11.17 (B1)
+mem_data<10>: U7.13 (D2), U9.13 (Q2), U11.16 (B2)
+mem_data<11>: U7.15 (D3), U9.15 (Q3), U11.15 (B3)
+mem_data<12>: U7.16 (D4), U9.16 (Q4), U11.14 (B4)
+mem_data<13>: U7.17 (D5), U9.17 (Q5), U11.13 (B5)
+mem_data<14>: U7.18 (D6), U9.18 (Q6), U11.12 (B6)
+mem_data<15>: U7.19 (D7), U9.19 (Q7), U11.11 (B7)
+pav: U14.11 (LE), U15.11 (LE)
-ddin_buf: U10.1 (A->B), U11.1 (A->B), U12.1 (A->B), U13.1 (A->B)
-eprom_cs: U6.20 (~CS), U7.20 (~CS)
-io_edata_oe: U12.19 (CE)
-io_odata_oe: U13.19 (CE)
-mem_data_oe: U10.19 (CE), U11.19 (CE)
-rd: U6.22 (~OE), U7.22 (~OE), U8.22 (~OE), U9.22 (~OE)
-sram_cs: U8.20 (~CS), U9.20 (~CS)
-wr_e: JP1.3 (B), U8.27 (~WE)
-wr_o: JP2.3 (B), U9.27 (~WE)
GND: C32.2, C33.2, C34.2, C35.2, C36.2, C37.2, C38.2, C39.2, C40.2, C41.2, C42.2, C43.2, C44.2, C45.2, C46.2, C47.2, U6.14 (GND), U7.14 (GND), U8.14 (GND), U9.14 (GND), U10.10 (GND), U11.10 (GND), U12.10 (GND), U13.10 (GND), U14.1 (OE), U14.10 (GND), U15.1 (OE), U15.10 (GND), U16.1 (OEa), U16.10 (GND), U16.19 (OEb)
unnamed: JP1.2 (C), U6.27 (~WE)
unnamed: JP2.2 (C), U7.27 (~WE)
VCC: C32.1, C33.1, C34.1, C35.1, C36.1, C37.1, C38.1, C39.1, C40.1, C41.1, C42.1, C43.1, C44.1, C45.1, C46.1, C47.1, JP1.1 (A), JP2.1 (A), U6.28 (VCC), U7.28 (VCC), U8.28 (VCC), U9.28 (VCC), U10.20 (VCC), U11.20 (VCC), U12.20 (VCC), U13.20 (VCC), U14.20 (VCC), U15.20 (VCC), U16.20 (VCC)

Notes on the sheet:
Odd
eprom_o
Address Bus Latches
EEPROM write protect
adr_latch_m
EEPROM
sram_e
tied high RR5 pin 10
Even
adr_latch_l
SRAM
IO Data Bus Latches
Memory Data Bus Latches
default
io_data_xcv_e
mem_data_xcv_o
mem_data_xcv_e
Note: orginal design specified 27C256 EPROMs but substituted 28C256 EEPROMs with slightly different pin-out (1=A14, 27=WR#)
eprom_e
sram_o
io_data_xcv_o
adr_buf_h
